NorthernWidget/DataCollector-Foley-Mechatronics/Software/README.md

How to use ArduinoJson

https://github.com/bblanchon/ArduinoJson
