NorthernWidget/DataCollector-Foley-Mechatronics/Final_Presentation/graphics/layering.docx

S6

S5

S4

S3

S2

S1

Main Controller

XBee

Wixel

GSM Module

Gateway API

Data Logger API

Data Service

Wireless Sensor API

Sensor Service
