NorthernWidget/DataCollector-Foley-Mechatronics/Final_Presentation/graphics/GeoLog.pdf

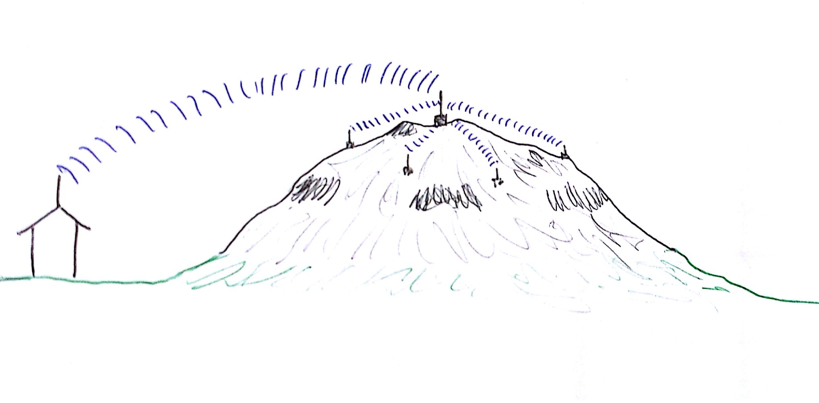
[picture p33: figure]

Scanned by CamScanner
