NorthernWidget/DataCollector-Foley-Mechatronics/Field pictures/IMG_4600.JPG

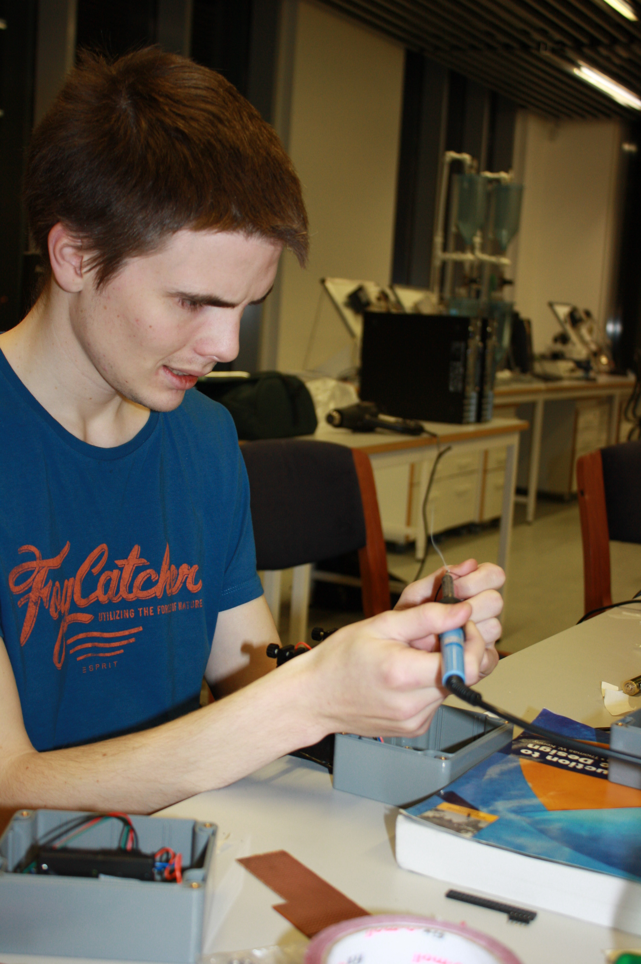
Field pictures/IMG_4600.JPG
