NorthernWidget/DataCollector-Foley-Mechatronics/Field pictures/IMG_4601.JPG

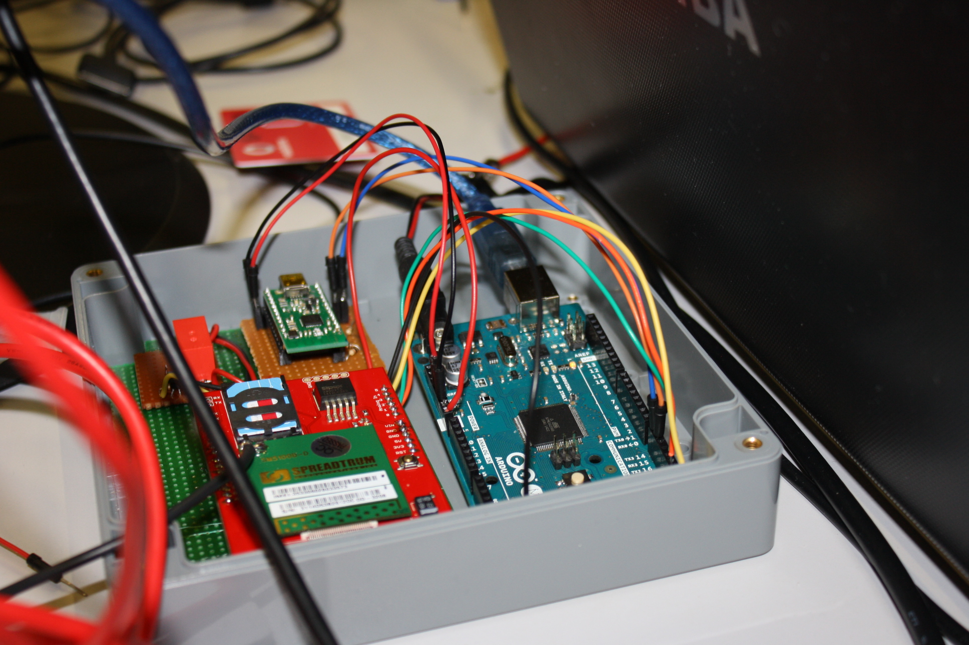
Field pictures/IMG_4601.JPG
