NorthernWidget/DataCollector-Foley-Mechatronics/Field pictures/IMG_4602.JPG

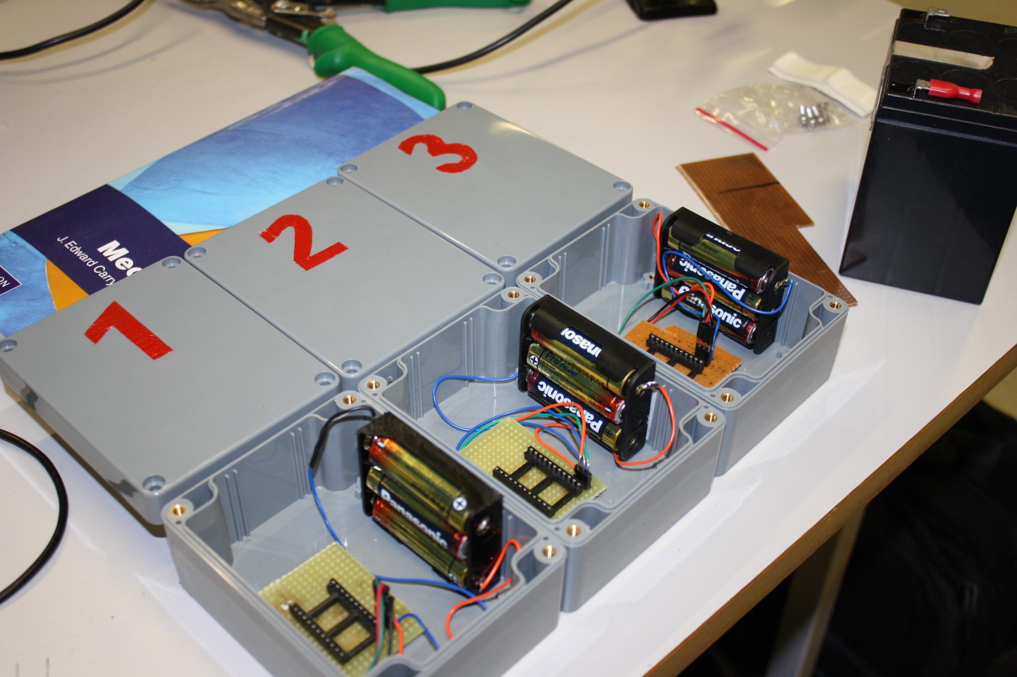
Field pictures/IMG_4602.JPG
