NorthernWidget/DataCollector-Foley-Mechatronics/Field pictures/IMG_4603.JPG

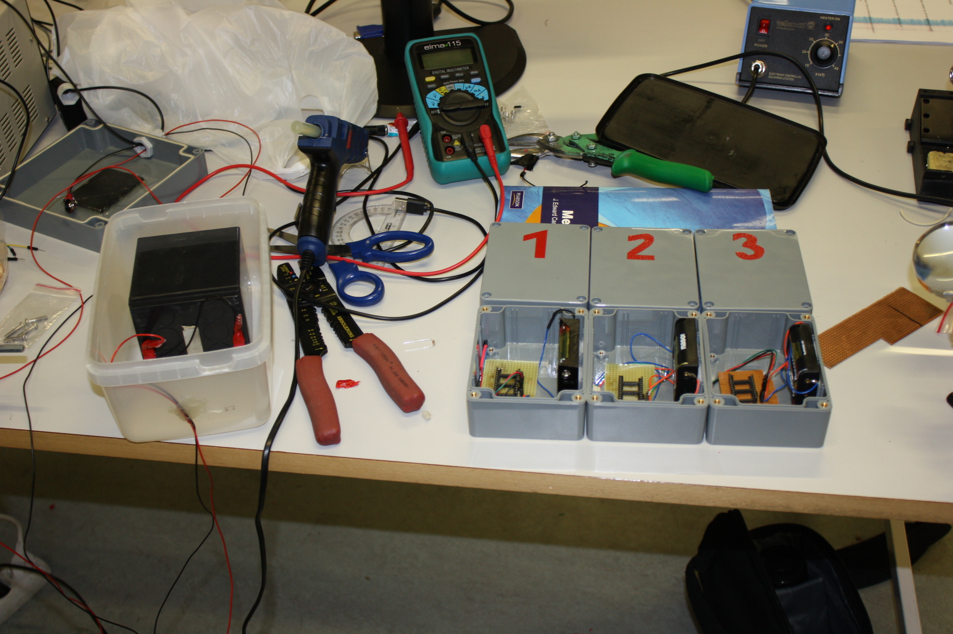
Field pictures/IMG_4603.JPG
