NorthernWidget/DataCollector-Foley-Mechatronics/Field pictures/IMG_4604.JPG

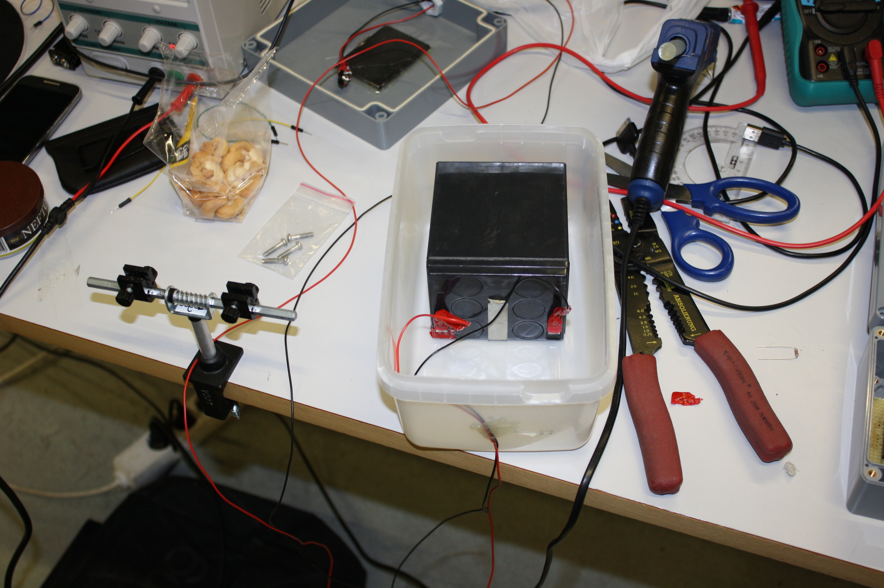
Field pictures/IMG_4604.JPG
