NorthernWidget/DataCollector-Foley-Mechatronics/Field pictures/IMG_4605.JPG

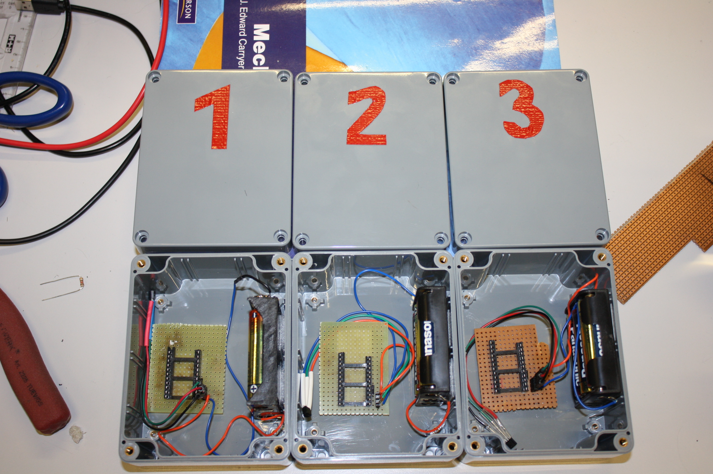
Field pictures/IMG_4605.JPG
