NorthernWidget/DataCollector-Foley-Mechatronics/Field pictures/IMG_4606.JPG

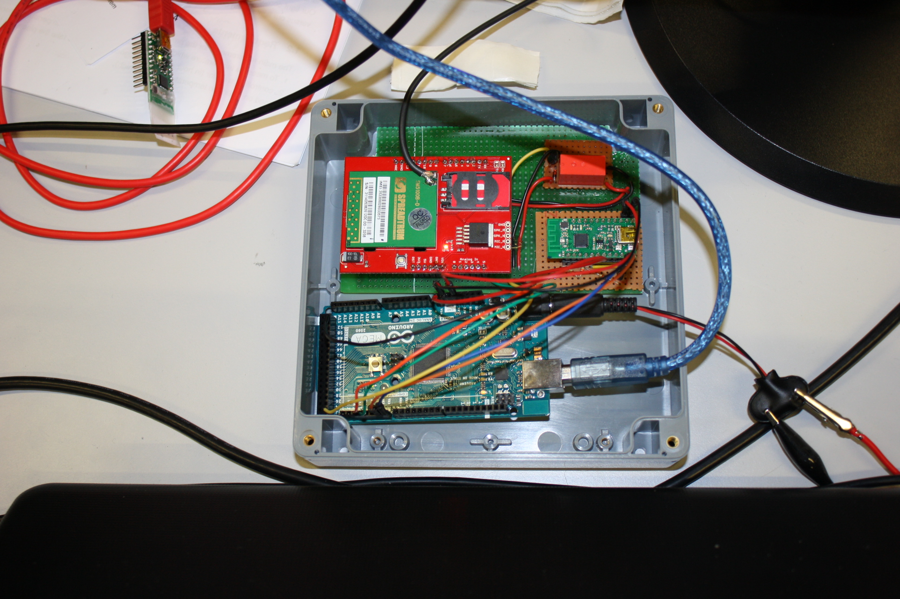
Field pictures/IMG_4606.JPG
