NorthernWidget/DataCollector-Foley-Mechatronics/Field pictures/IMG_4607.JPG

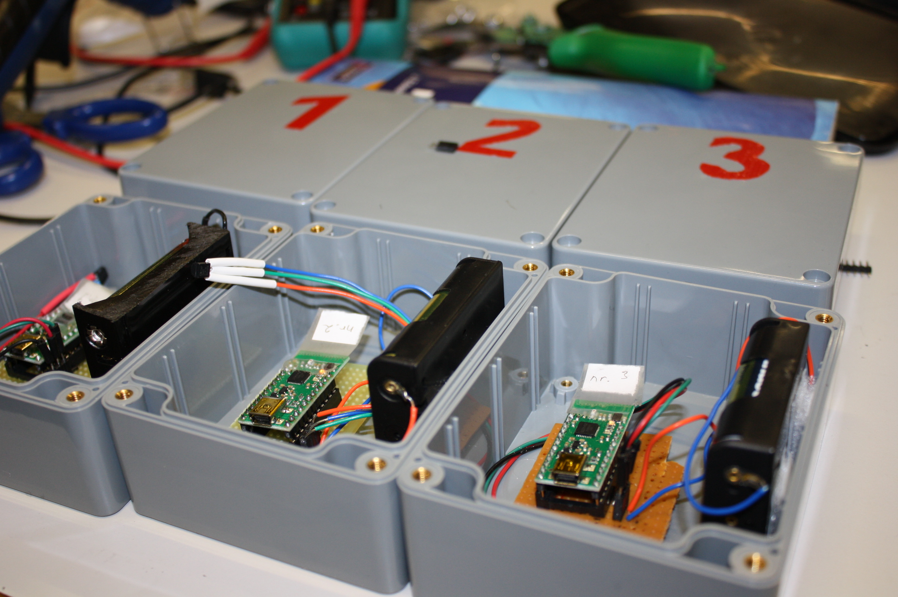
Field pictures/IMG_4607.JPG
