NorthernWidget/DataCollector-Foley-Mechatronics/Field pictures/IMG_4608.JPG

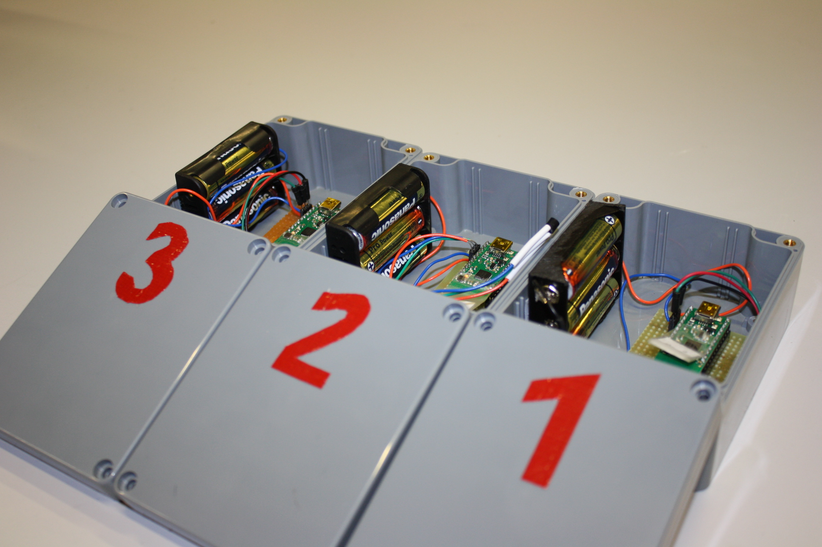
Field pictures/IMG_4608.JPG
