NorthernWidget/DataCollector-Foley-Mechatronics/Field pictures/IMG_4609.JPG

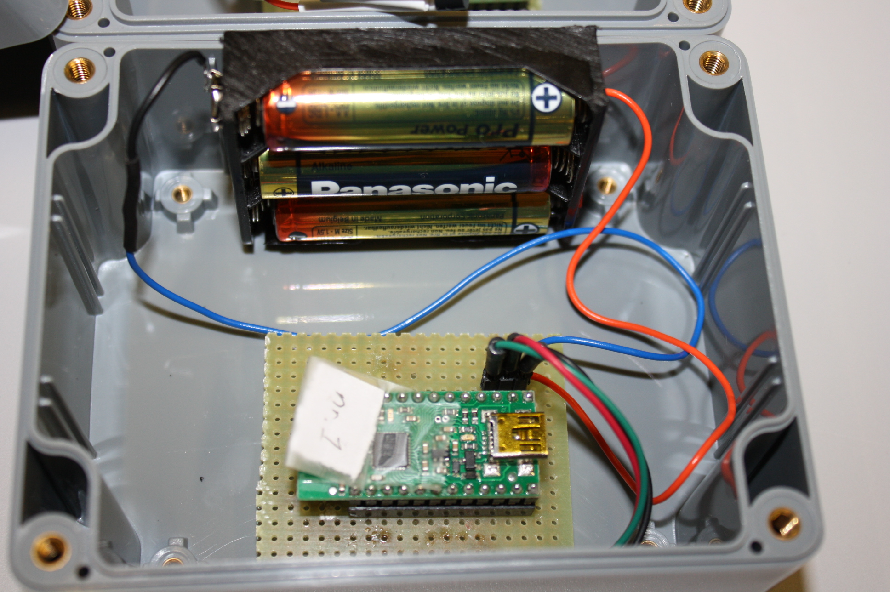
Field pictures/IMG_4609.JPG
