NorthernWidget/DataCollector-Foley-Mechatronics/Field pictures/IMG_4610.JPG

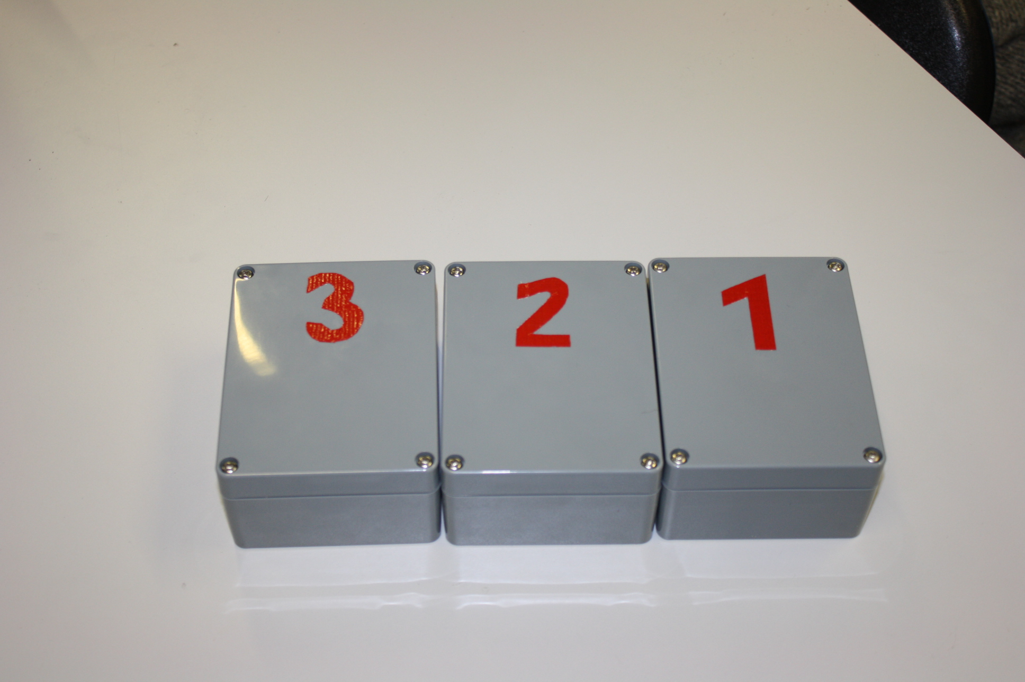
Field pictures/IMG_4610.JPG
