NorthernWidget/DataCollector-Foley-Mechatronics/Field pictures/IMG_4611.JPG

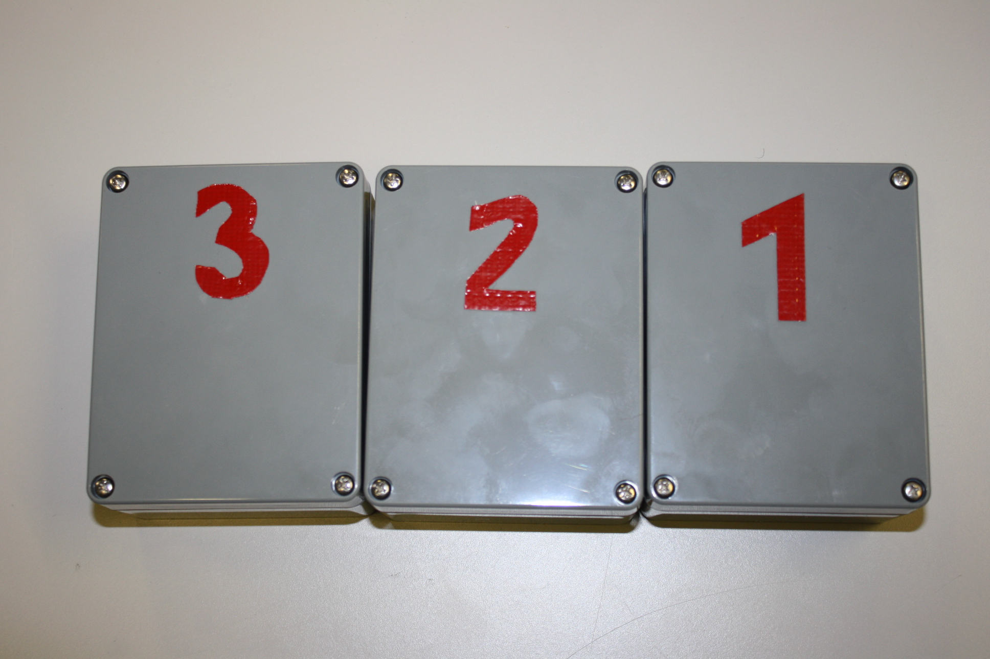
Field pictures/IMG_4611.JPG
