NorthernWidget/DataCollector-Foley-Mechatronics/Field pictures/IMG_4612.JPG

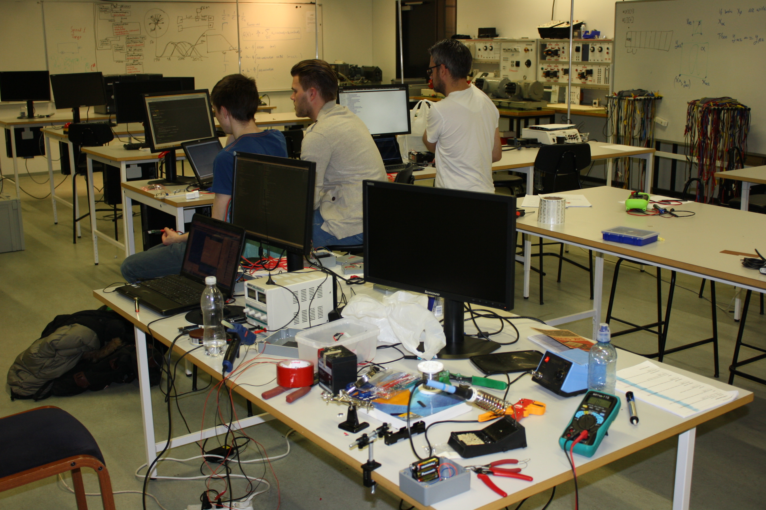
Field pictures/IMG_4612.JPG
