NorthernWidget/DataCollector-Foley-Mechatronics/Field pictures/IMG_4613.JPG

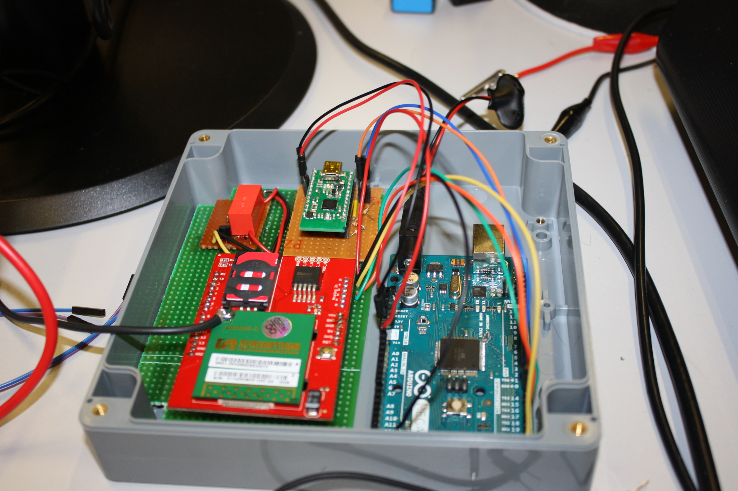
Field pictures/IMG_4613.JPG
