NorthernWidget/DataCollector-Foley-Mechatronics/Field pictures/IMG_4615.JPG

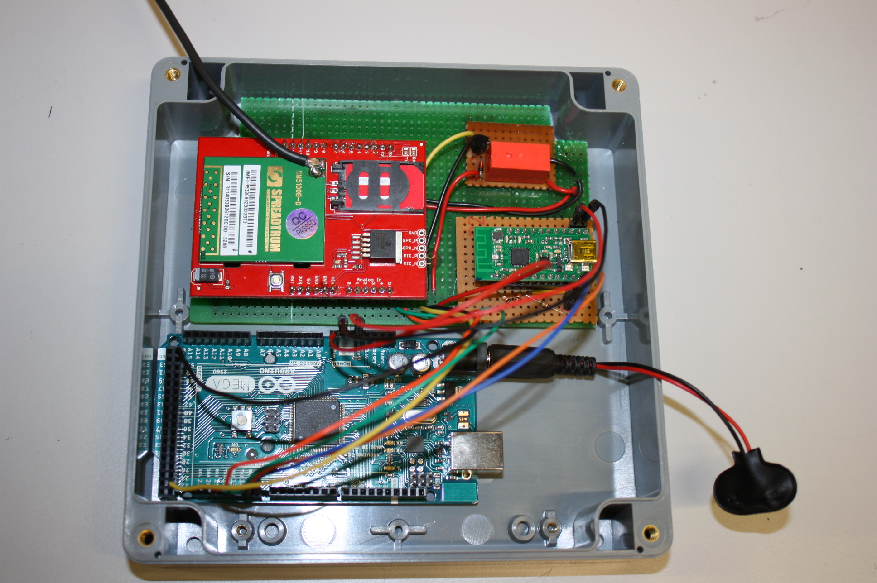
Field pictures/IMG_4615.JPG
