NorthernWidget/DataCollector-Foley-Mechatronics/Field pictures/IMG_4616.JPG

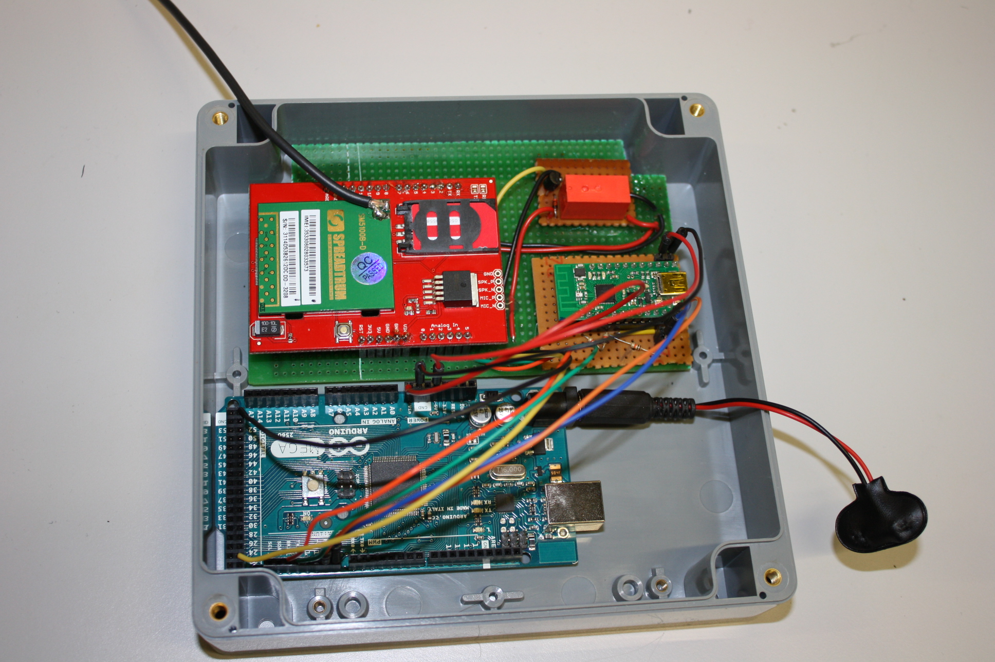
Field pictures/IMG_4616.JPG
