NorthernWidget/DataCollector-Foley-Mechatronics/Field pictures/IMG_4617.JPG

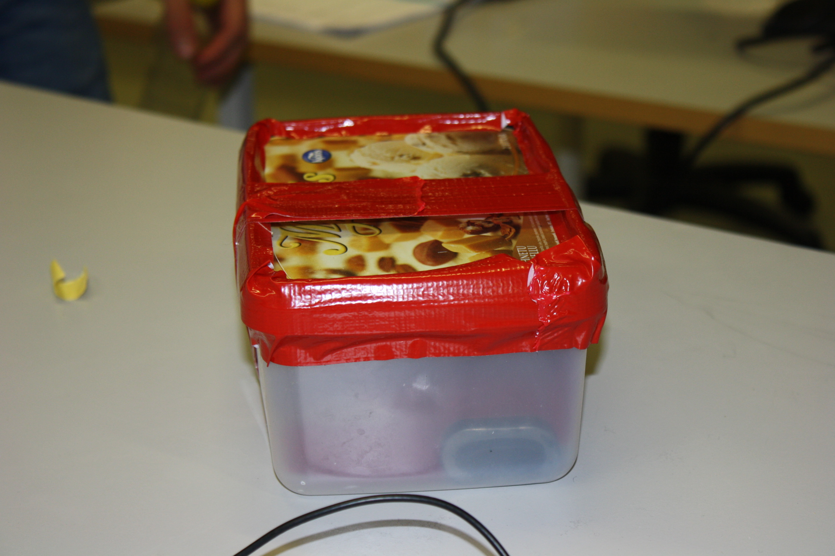
Field pictures/IMG_4617.JPG
