NorthernWidget/DataCollector-Foley-Mechatronics/Field pictures/IMG_4618.JPG

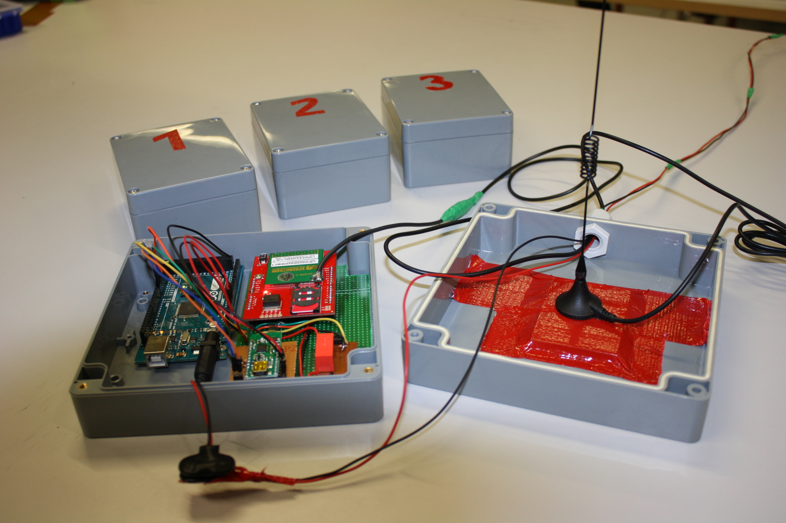
Field pictures/IMG_4618.JPG
