NorthernWidget/DataCollector-Foley-Mechatronics/Field pictures/IMG_4619.JPG

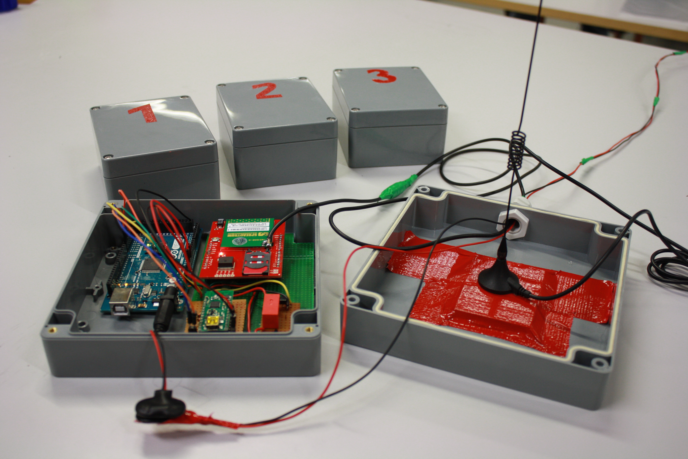
Field pictures/IMG_4619.JPG
