NorthernWidget/DataCollector-Foley-Mechatronics/Field pictures/IMG_4620.JPG

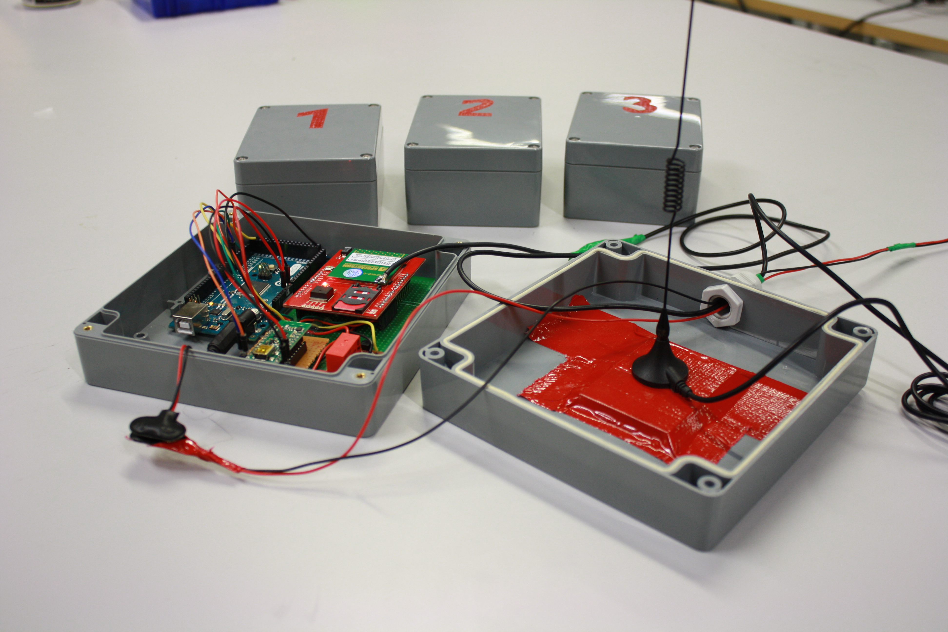
Field pictures/IMG_4620.JPG
