NorthernWidget/DataCollector-Foley-Mechatronics/Field pictures/IMG_4621.JPG

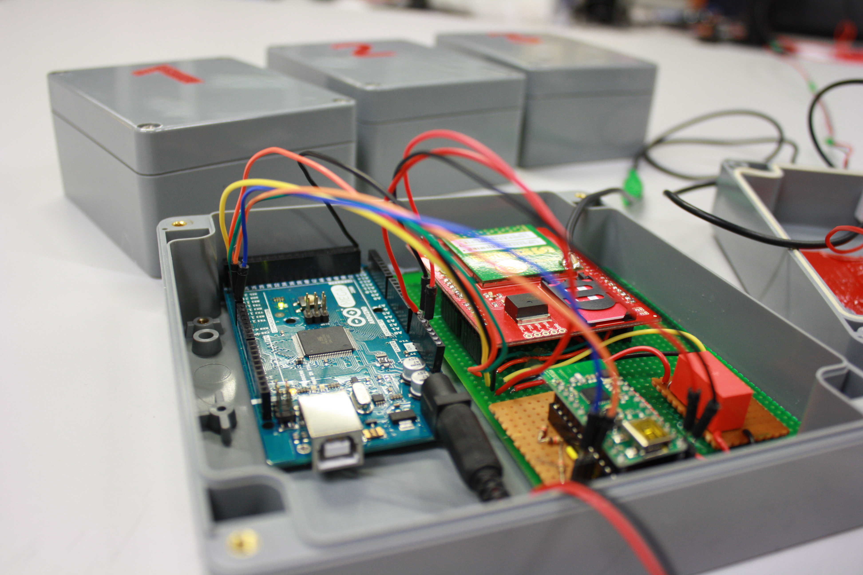
Field pictures/IMG_4621.JPG
