NorthernWidget/DataCollector-Foley-Mechatronics/Field pictures/IMG_4622.JPG

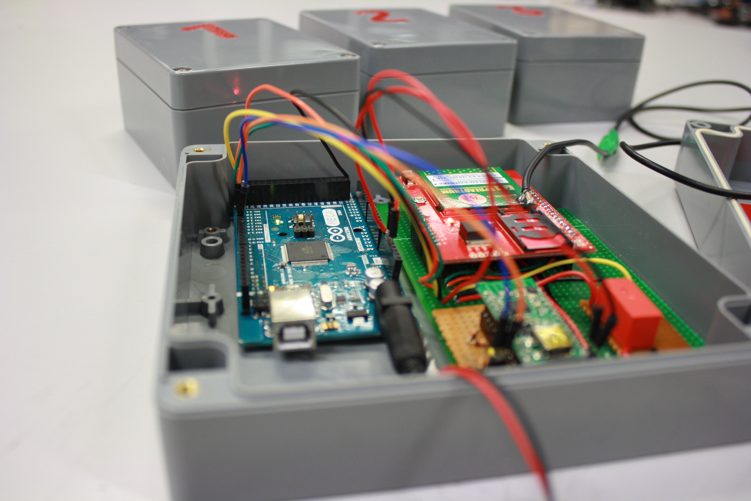
Field pictures/IMG_4622.JPG
