NorthernWidget/DataCollector-Foley-Mechatronics/Field pictures/IMG_4623.JPG

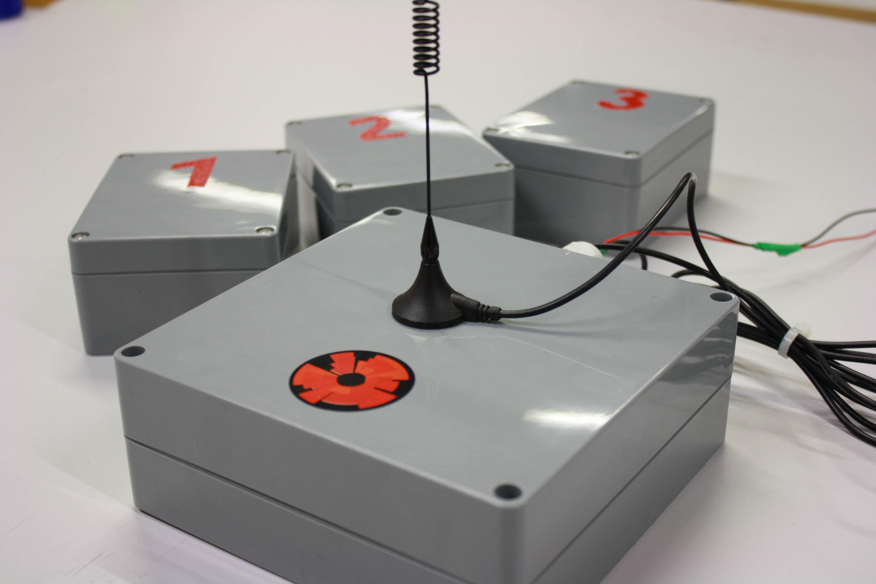
Field pictures/IMG_4623.JPG
