NorthernWidget/DataCollector-Foley-Mechatronics/Field pictures/IMG_4624.JPG

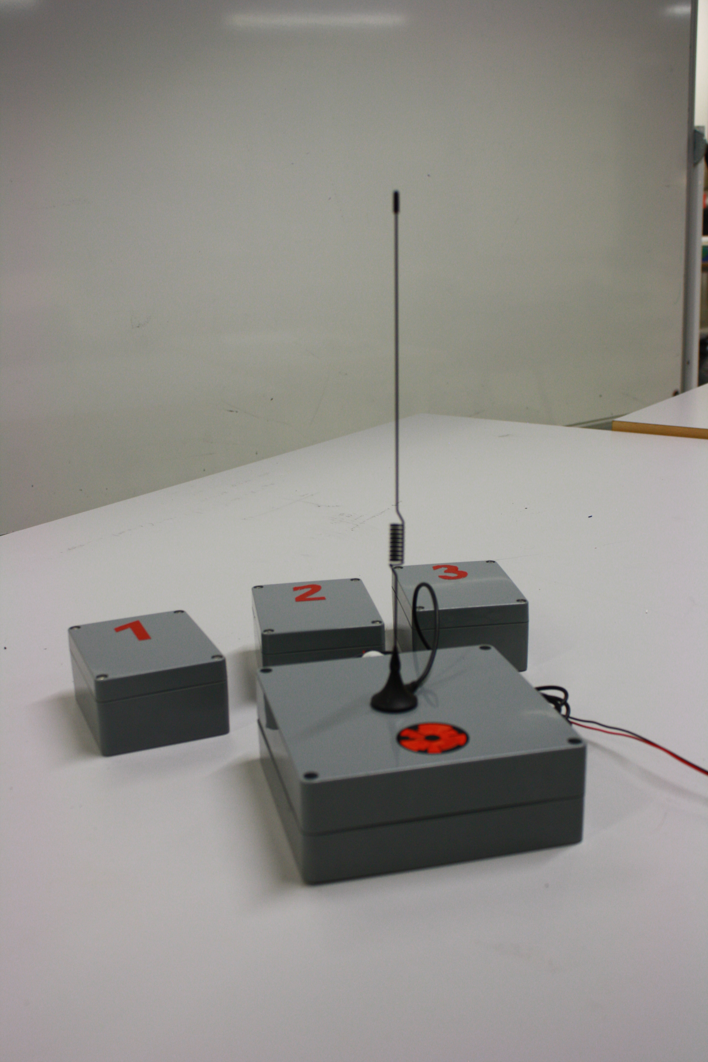
Field pictures/IMG_4624.JPG
