NorthernWidget/DataCollector-Foley-Mechatronics/Field pictures/IMG_4625.JPG

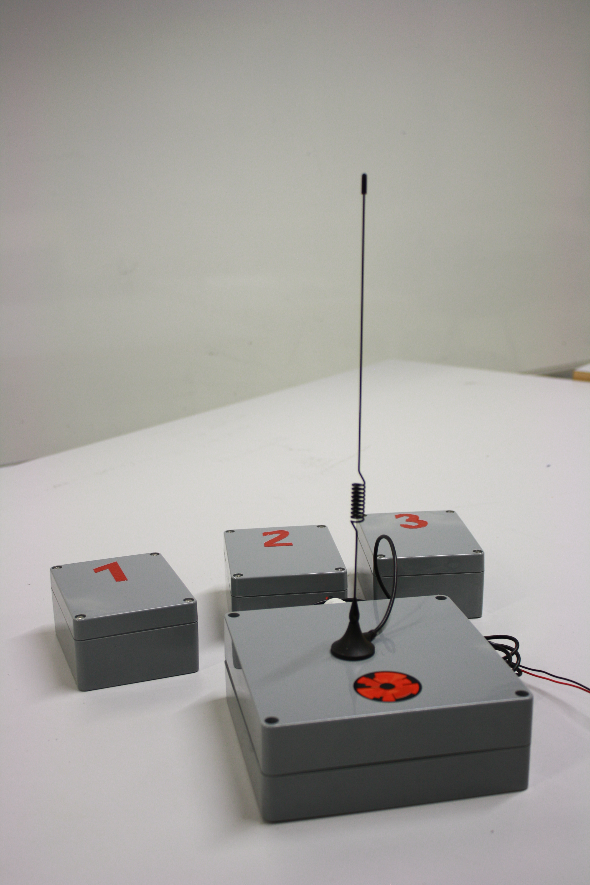
Field pictures/IMG_4625.JPG
