NorthernWidget/DataCollector-Foley-Mechatronics/Field pictures/IMG_4626.JPG

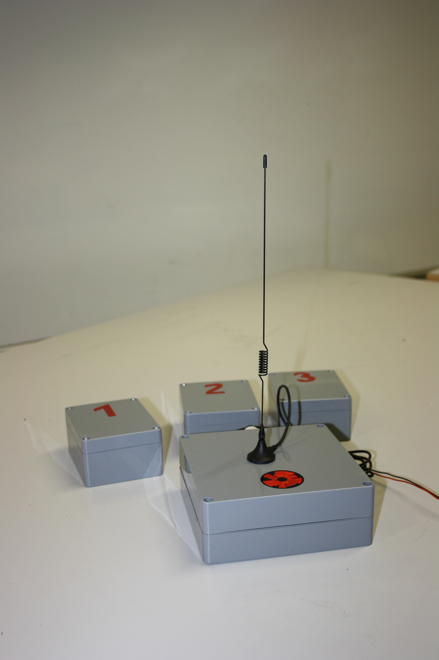
Field pictures/IMG_4626.JPG
