NorthernWidget/DataCollector-Foley-Mechatronics/Field pictures/IMG_4627.JPG

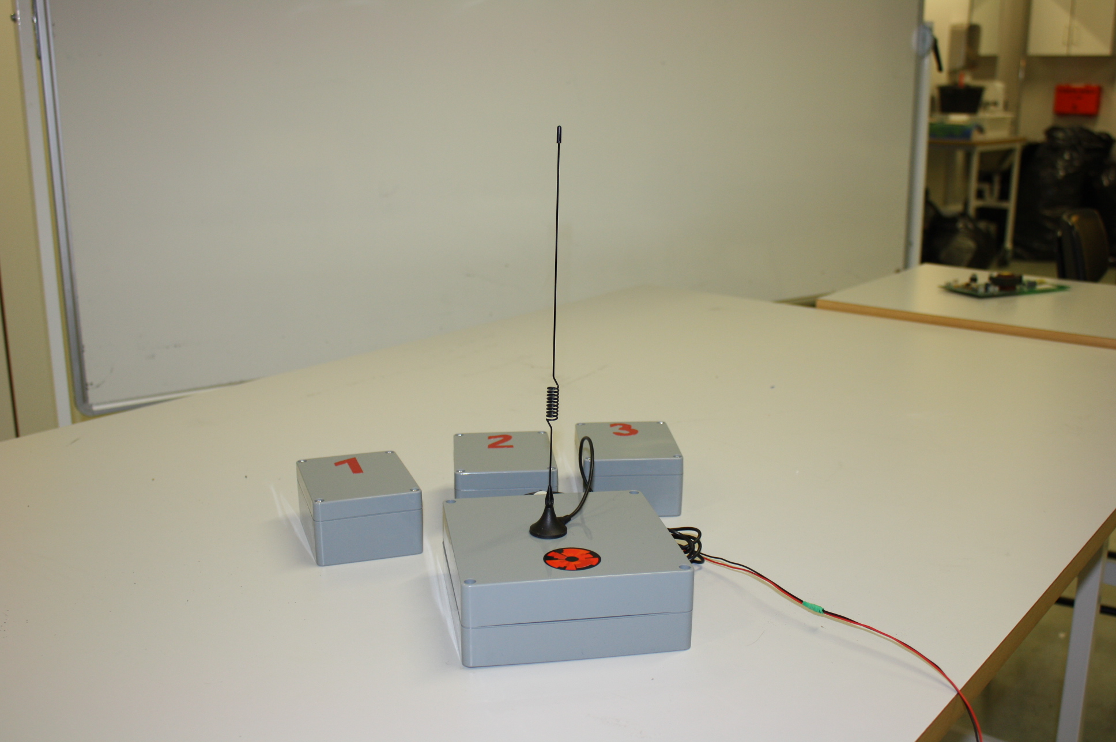
Field pictures/IMG_4627.JPG
