NorthernWidget/DataCollector-Foley-Mechatronics/Field pictures/IMG_4628.JPG

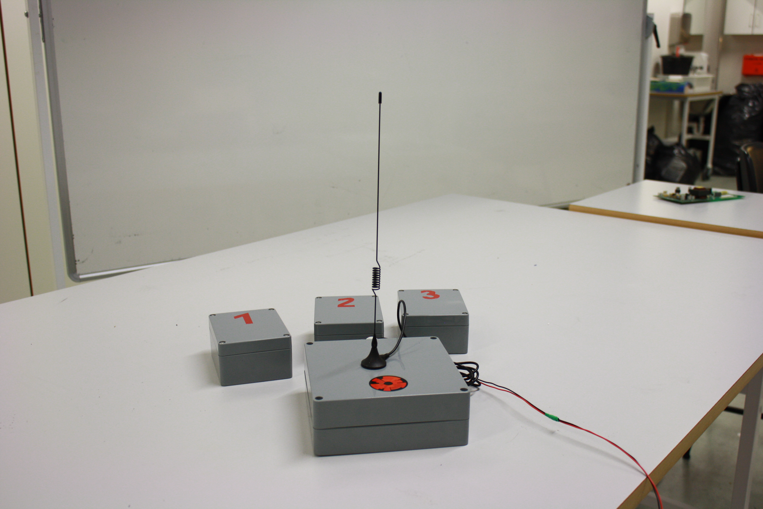
Field pictures/IMG_4628.JPG
