NorthernWidget/DataCollector-Foley-Mechatronics/Field pictures/IMG_4629.JPG

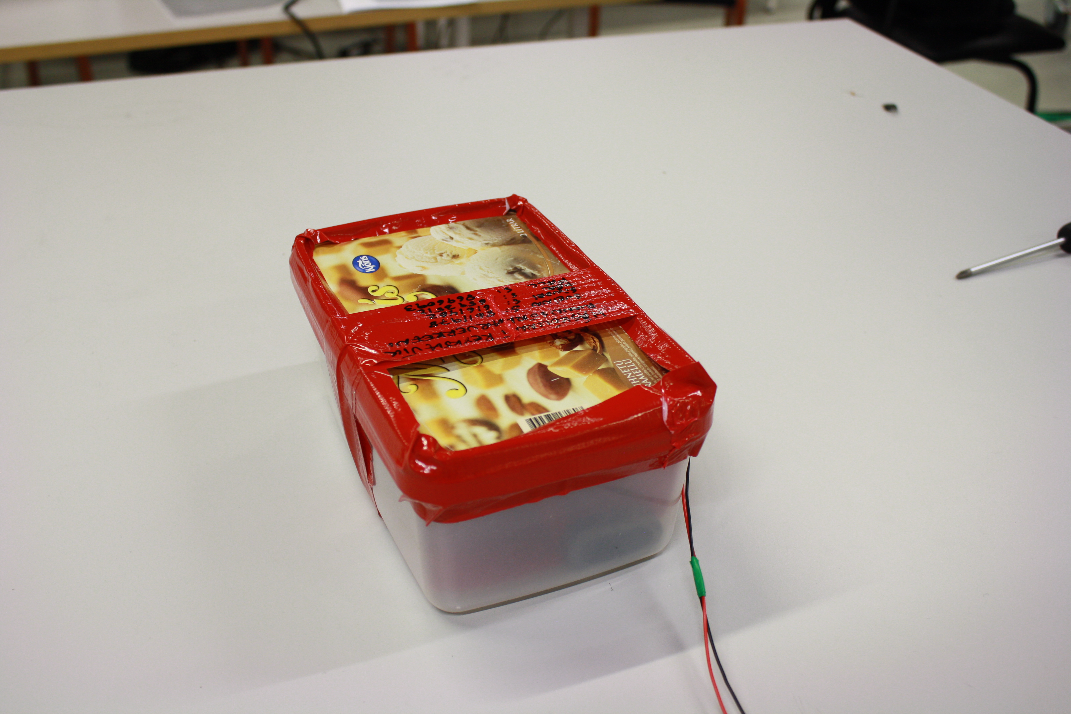
Field pictures/IMG_4629.JPG
