NorthernWidget/DataCollector-Foley-Mechatronics/Field pictures/IMG_4630.JPG

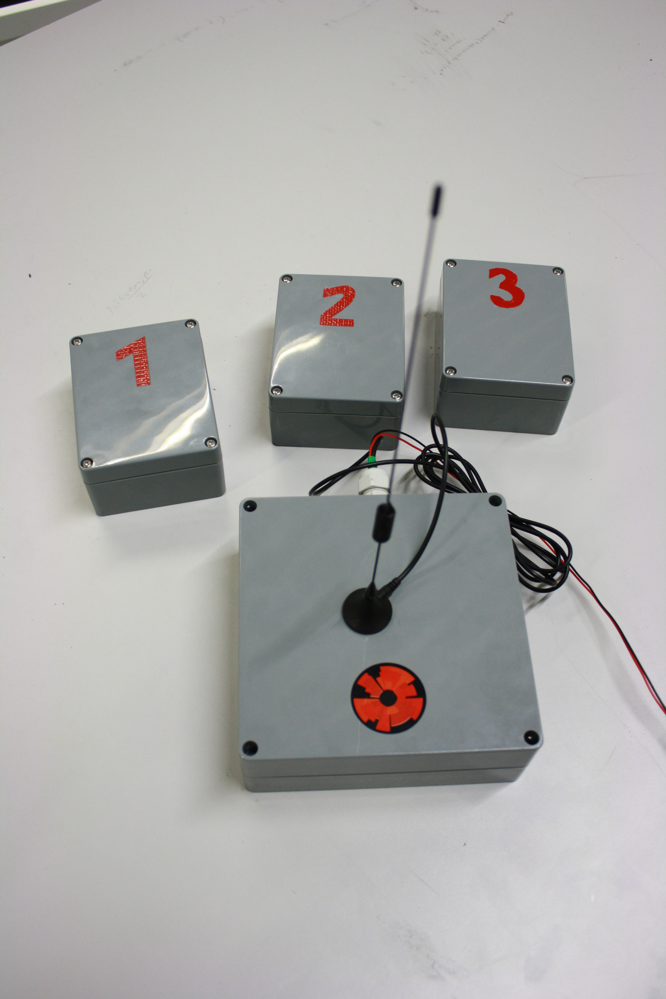
Field pictures/IMG_4630.JPG
