NorthernWidget/DataCollector-Foley-Mechatronics/Field pictures/IMG_4631.JPG

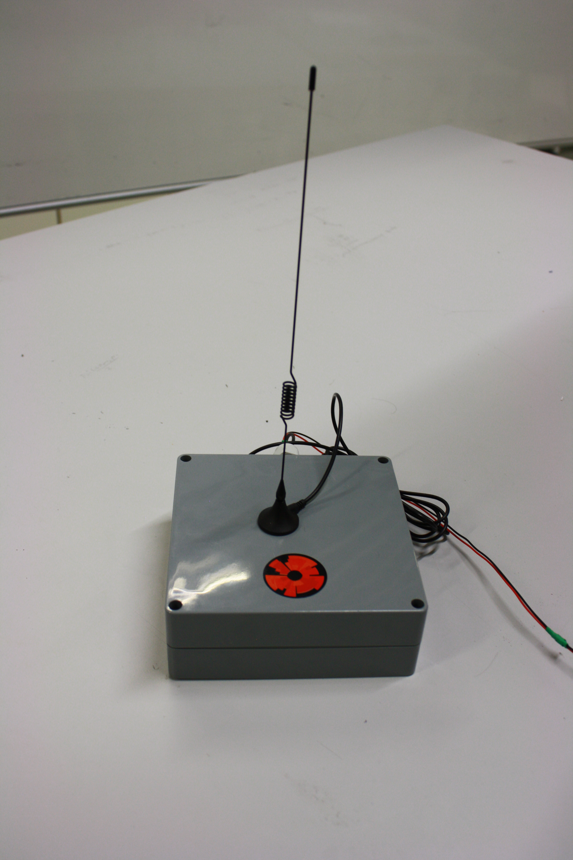
Field pictures/IMG_4631.JPG
