NorthernWidget/DataCollector-Foley-Mechatronics/Field pictures/IMG_4632.JPG

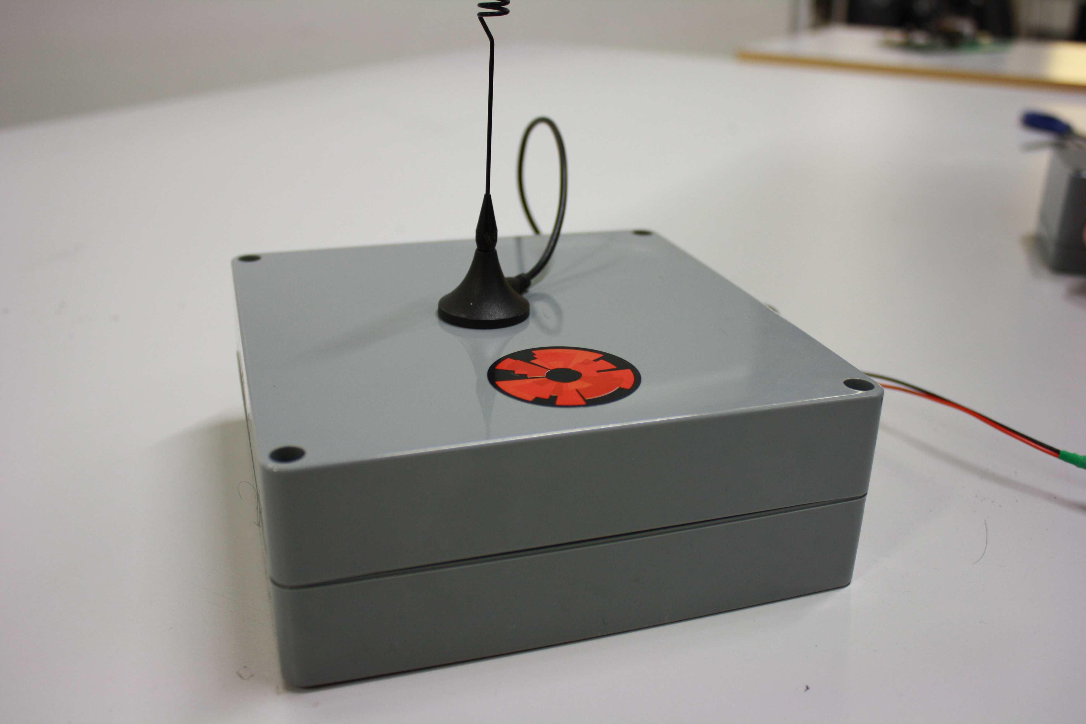
Field pictures/IMG_4632.JPG
