NorthernWidget/DataCollector-Foley-Mechatronics/Field pictures/IMG_4633.JPG

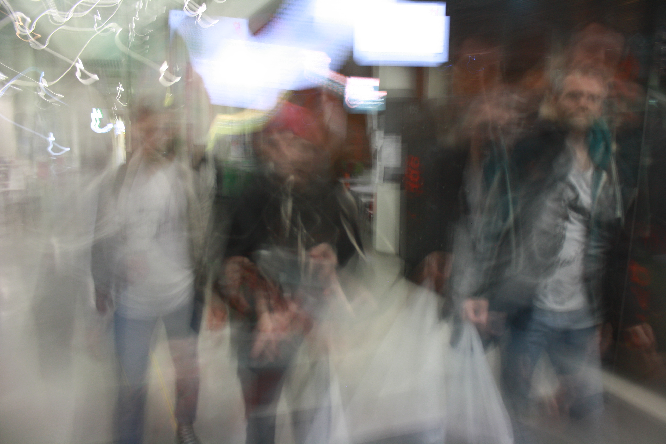
Field pictures/IMG_4633.JPG
