NorthernWidget/DataCollector-Foley-Mechatronics/Field pictures/IMG_4634.JPG

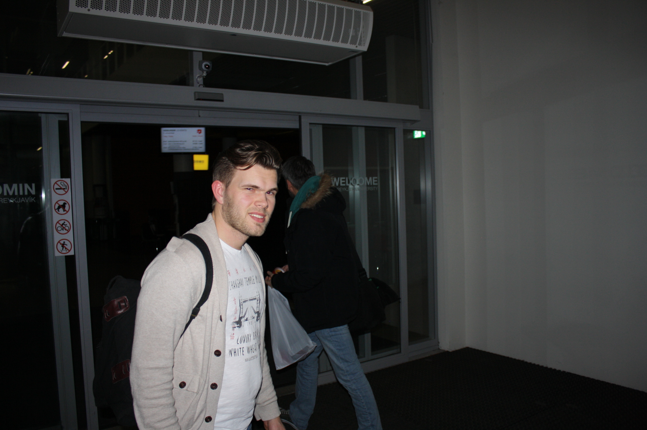
Field pictures/IMG_4634.JPG
