NorthernWidget/DataCollector-Foley-Mechatronics/Field pictures/IMG_4635.JPG

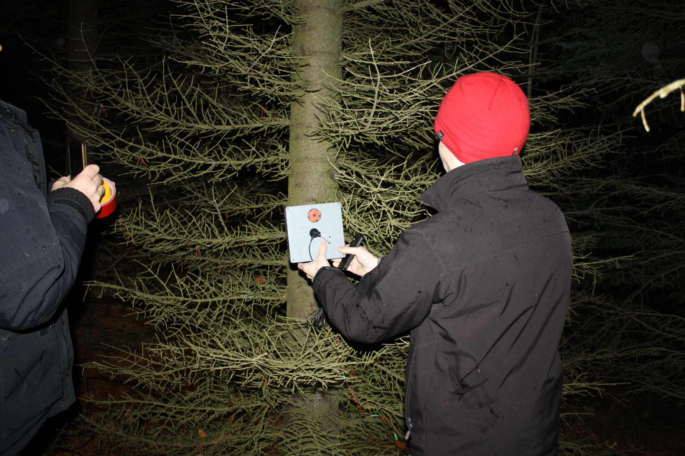
Field pictures/IMG_4635.JPG
