NorthernWidget/DataCollector-Foley-Mechatronics/Field pictures/IMG_4636.JPG

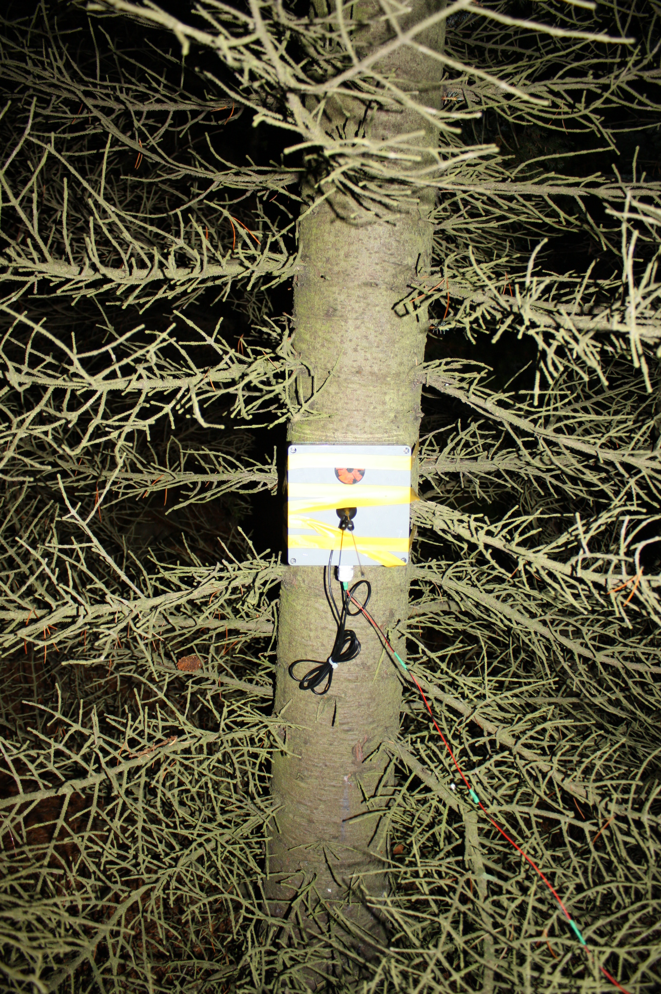
Field pictures/IMG_4636.JPG
