NorthernWidget/DataCollector-Foley-Mechatronics/Field pictures/IMG_4637.JPG

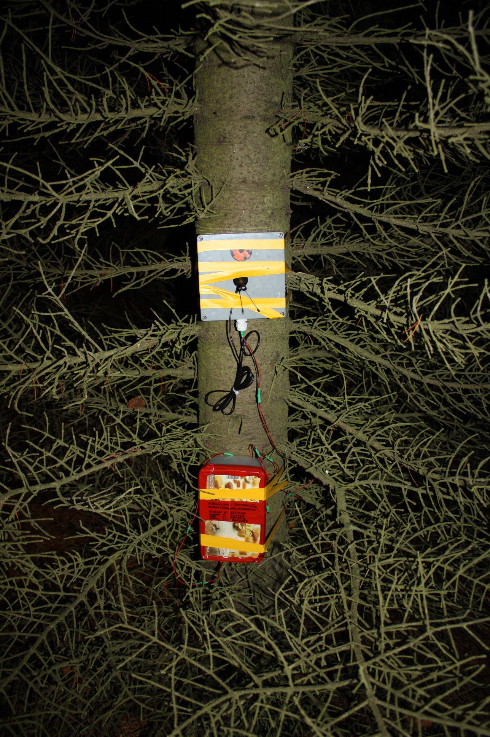
Field pictures/IMG_4637.JPG
