NorthernWidget/DataCollector-Foley-Mechatronics/Field pictures/IMG_4638.JPG

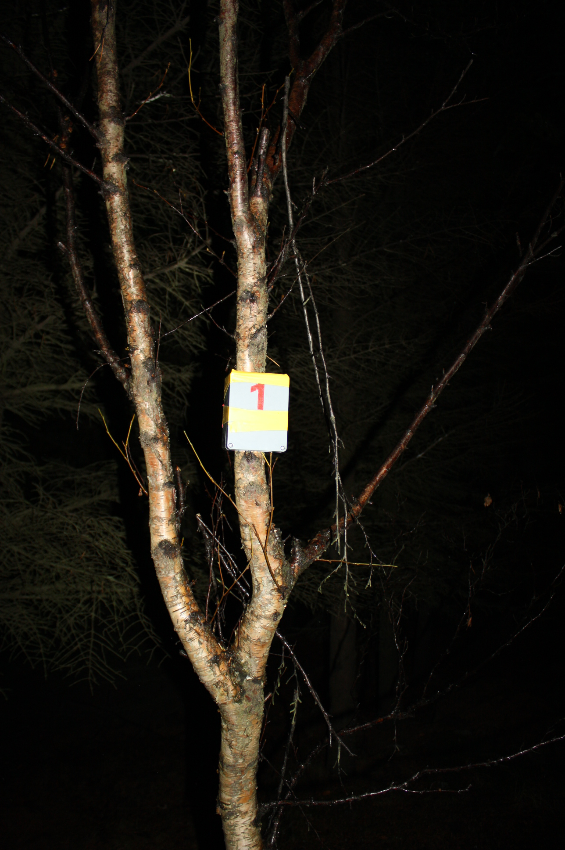
Field pictures/IMG_4638.JPG
