NorthernWidget/DataCollector-Foley-Mechatronics/Field pictures/IMG_4639.JPG

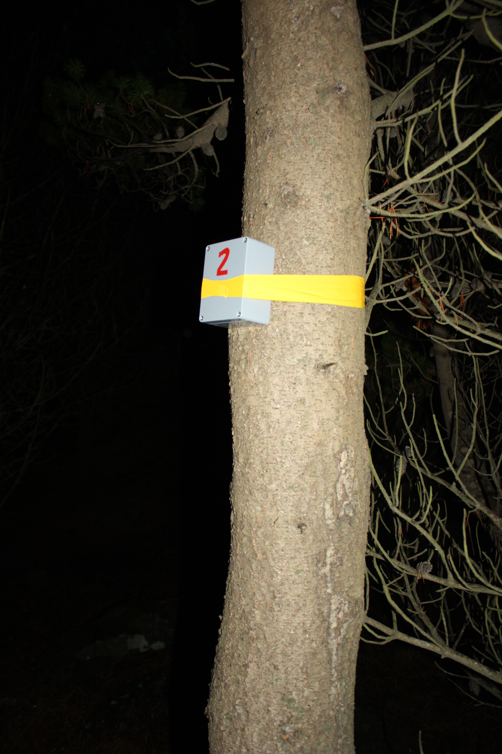
Field pictures/IMG_4639.JPG
