NorthernWidget/DataCollector-Foley-Mechatronics/Field pictures/IMG_4640.JPG

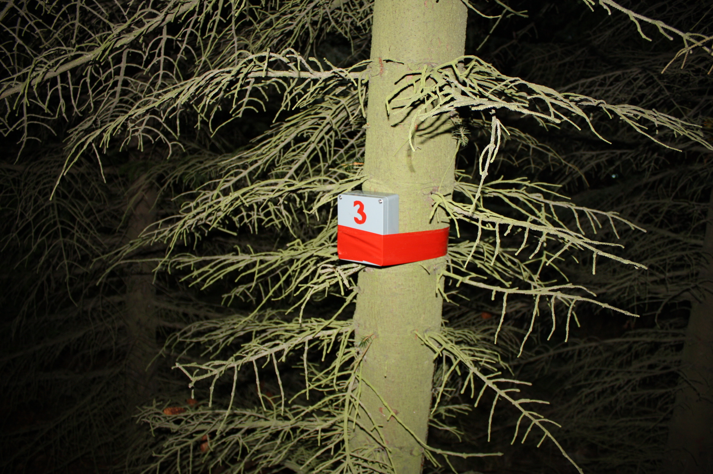
Field pictures/IMG_4640.JPG
