NorthernWidget/DataCollector-Foley-Mechatronics/Field pictures/IMG_4642.JPG

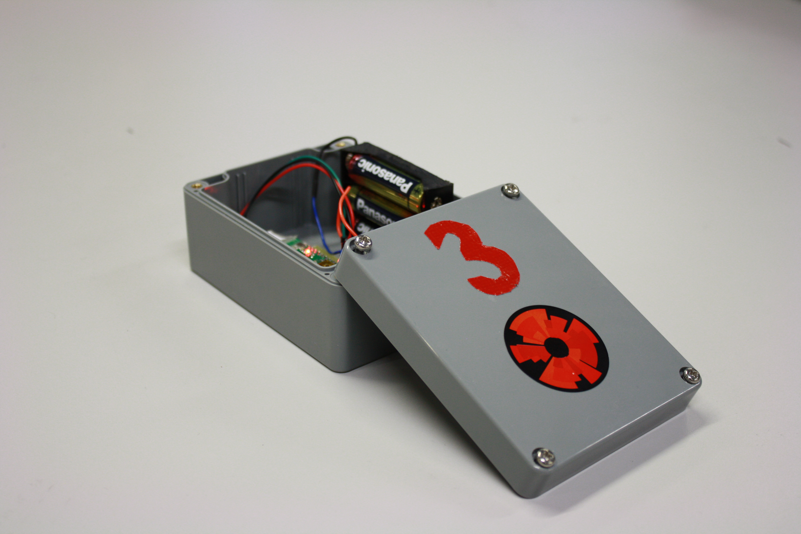
Field pictures/IMG_4642.JPG
