NorthernWidget/DataCollector-Foley-Mechatronics/Field pictures/IMG_4643.JPG

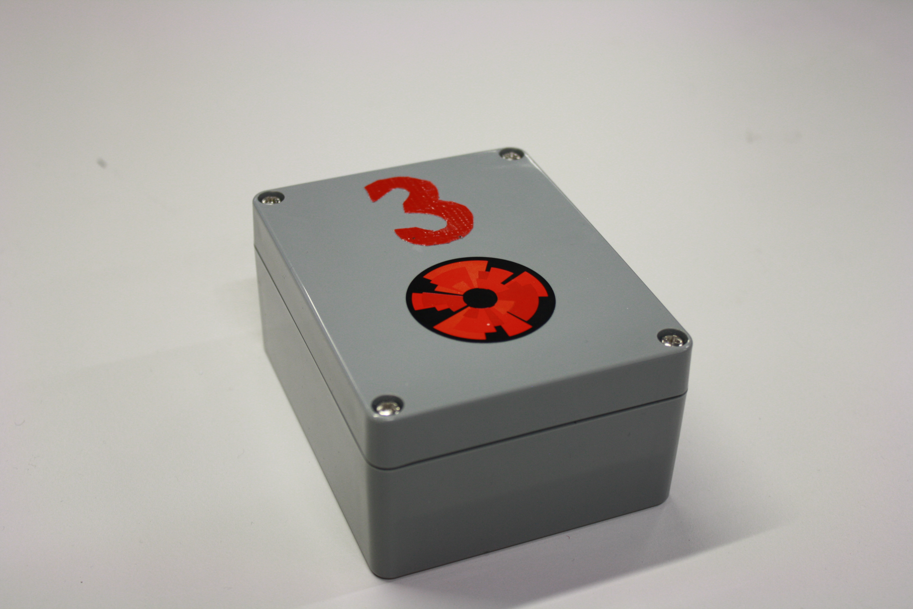
Field pictures/IMG_4643.JPG
