NorthernWidget/DataCollector-Foley-Mechatronics/Field pictures/IMG_4644.JPG

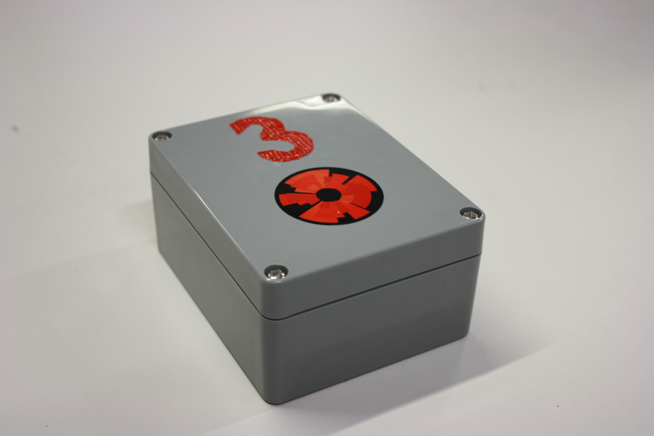
Field pictures/IMG_4644.JPG
