NorthernWidget/DataCollector-Foley-Mechatronics/Field pictures/IMG_4647.JPG

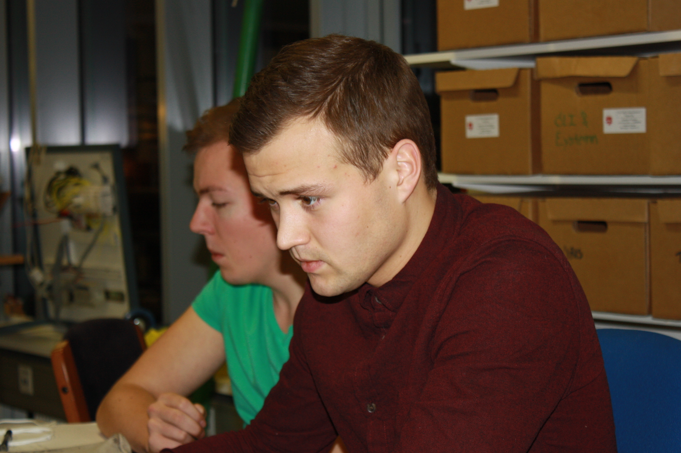
Field pictures/IMG_4647.JPG
