NorthernWidget/DataCollector-Foley-Mechatronics/Field pictures/IMG_4648.JPG

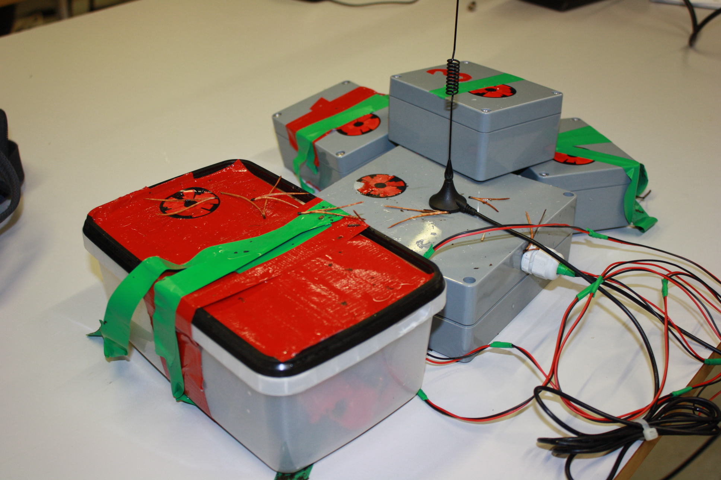
Field pictures/IMG_4648.JPG
