NorthernWidget/DataCollector-Foley-Mechatronics/Field pictures/IMG_4649.JPG

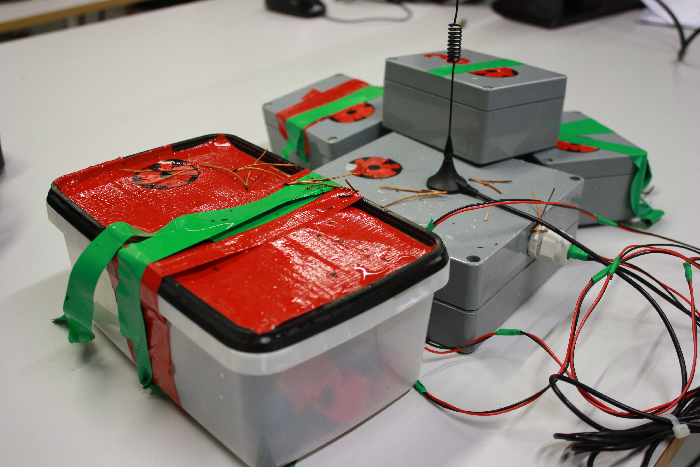
Field pictures/IMG_4649.JPG
