NorthernWidget/DataCollector-Foley-Mechatronics/Field pictures/IMG_4650.JPG

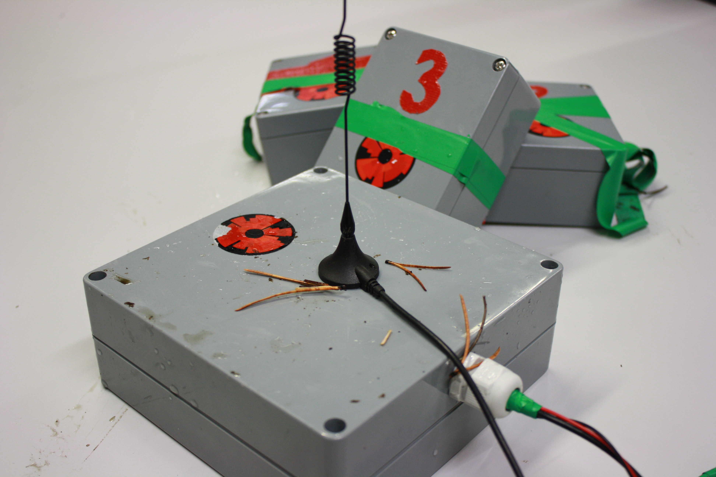
Field pictures/IMG_4650.JPG
