NorthernWidget/DataCollector-Foley-Mechatronics/Field pictures/IMG_4651.JPG

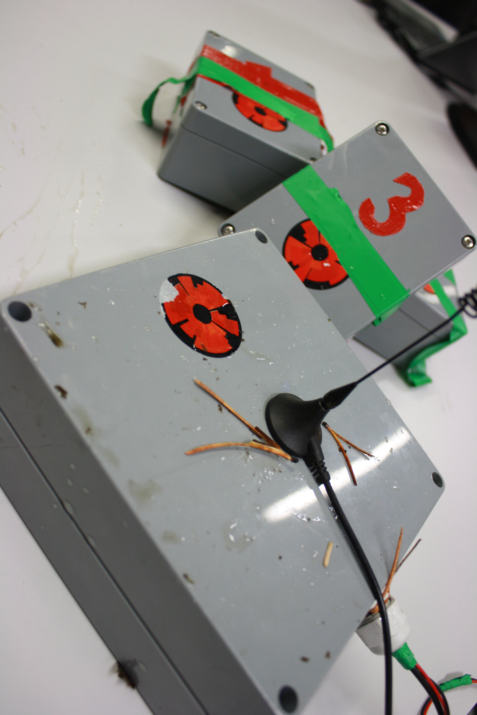
Field pictures/IMG_4651.JPG
