NorthernWidget/DataCollector-Foley-Mechatronics/Field pictures/IMG_4652.JPG

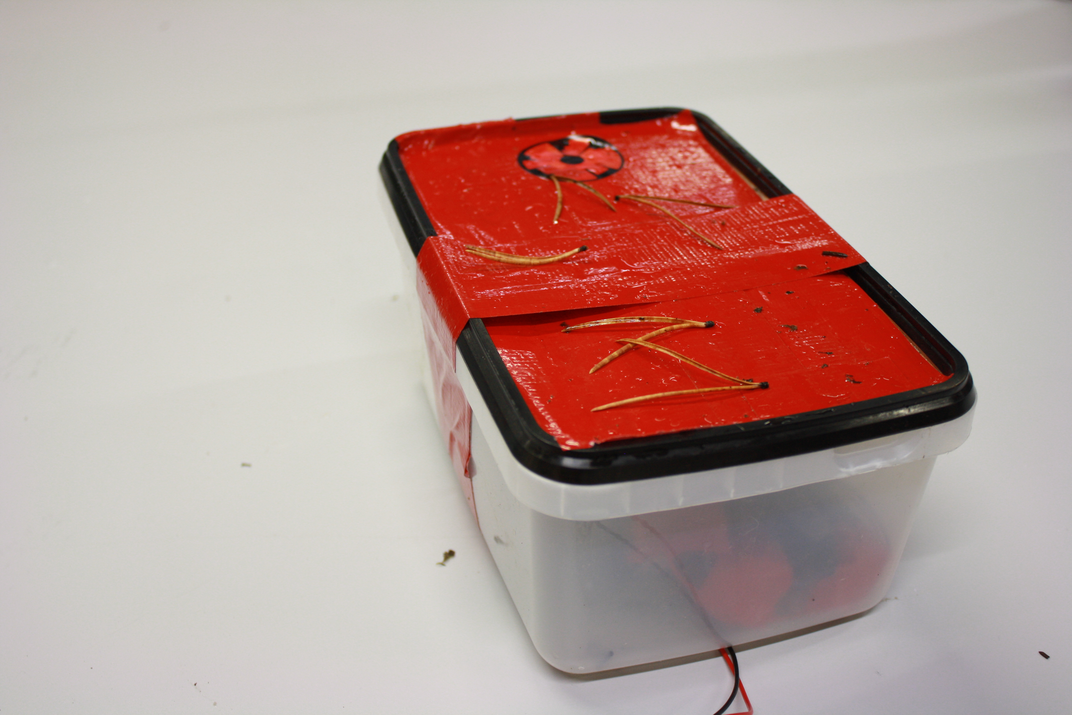
Field pictures/IMG_4652.JPG
