NorthernWidget/DataCollector-Foley-Mechatronics/Field pictures/IMG_4653.JPG

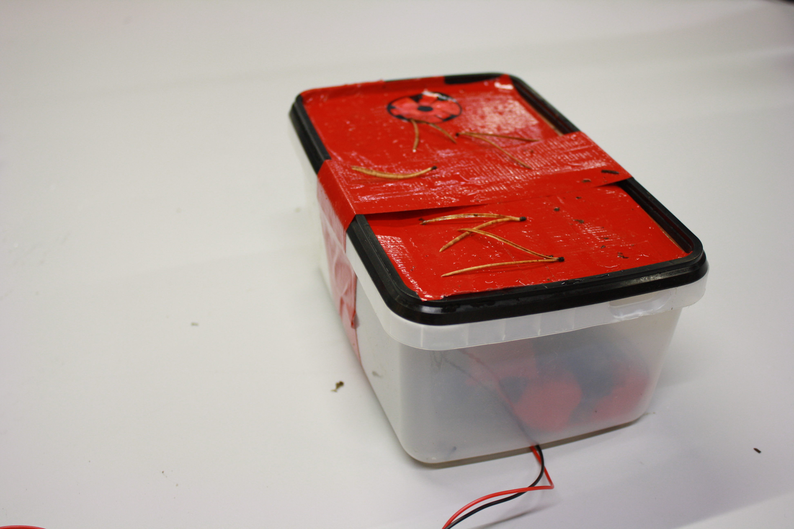
Field pictures/IMG_4653.JPG
