NorthernWidget/DataCollector-Foley-Mechatronics/Field pictures/Photo 5.11.2014, 03 38 04.jpg

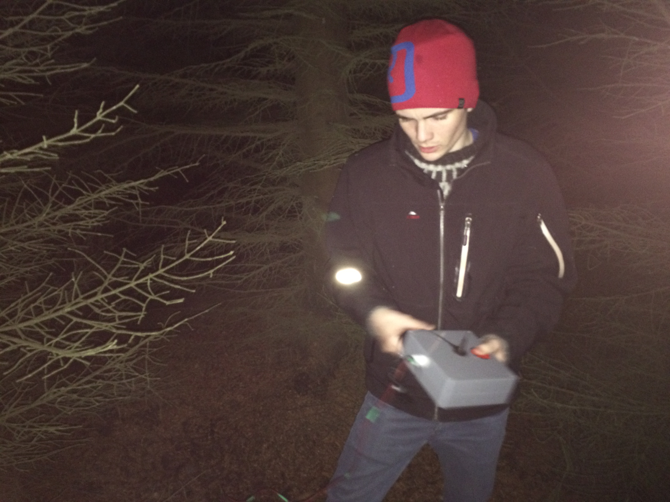
Field pictures/Photo 5.11.2014, 03 38 04.jpg
