NorthernWidget/DataCollector-Foley-Mechatronics/Field pictures/Photo 5.11.2014, 17 06 54.jpg

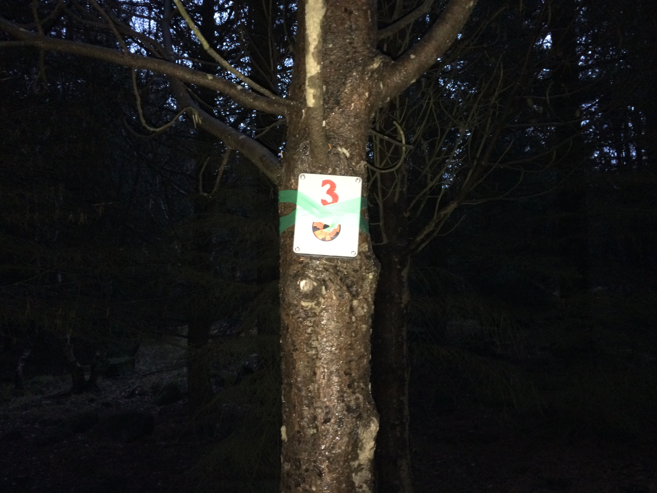
Field pictures/Photo 5.11.2014, 17 06 54.jpg
