NorthernWidget/DataCollector-Foley-Mechatronics/Field pictures/Photo 5.11.2014, 17 09 20.jpg

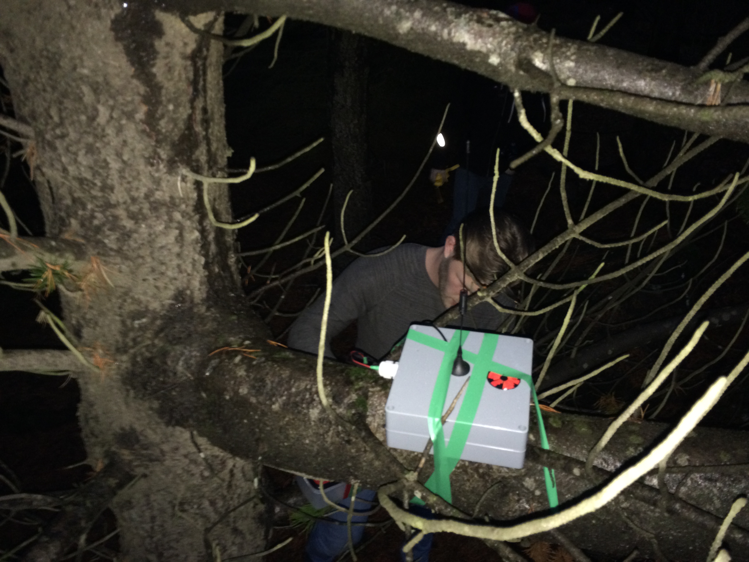
Field pictures/Photo 5.11.2014, 17 09 20.jpg
