NorthernWidget/DataCollector-Foley-Mechatronics/Final_Presentation/graphics/affordableWS.png

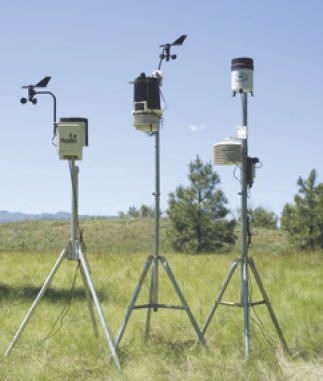
Final_Presentation/graphics/affordableWS.png
