NorthernWidget/DataCollector-Foley-Mechatronics/Final_Presentation/graphics/Field_pictures/Power.JPG

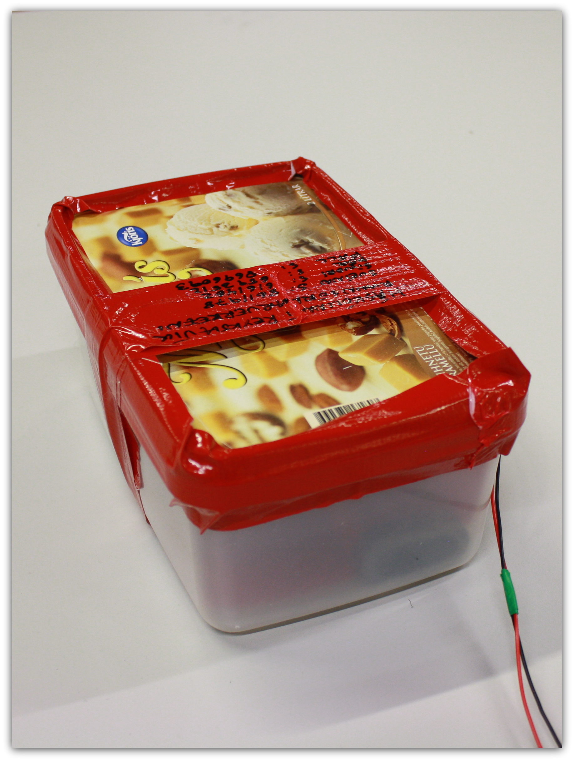
Final_Presentation/graphics/Field_pictures/Power.JPG
