NorthernWidget/DataCollector-Foley-Mechatronics/Final_Presentation/graphics/softwareArchitecture.png

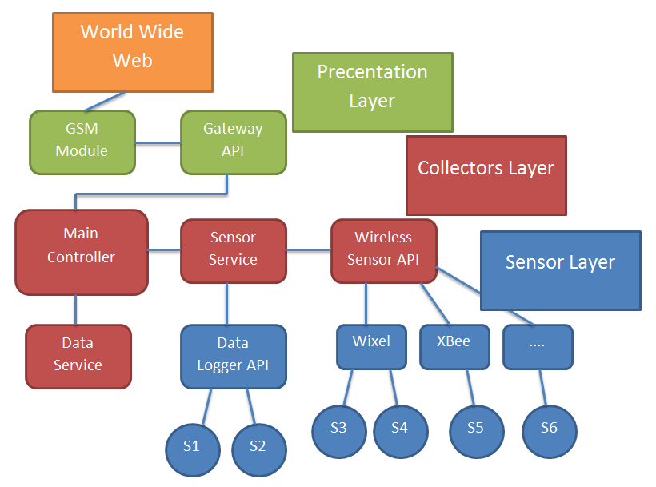
Final_Presentation/graphics/softwareArchitecture.png
