NorthernWidget/DataCollector-Foley-Mechatronics/Proposal/graphics/milestonePresentation.jpg

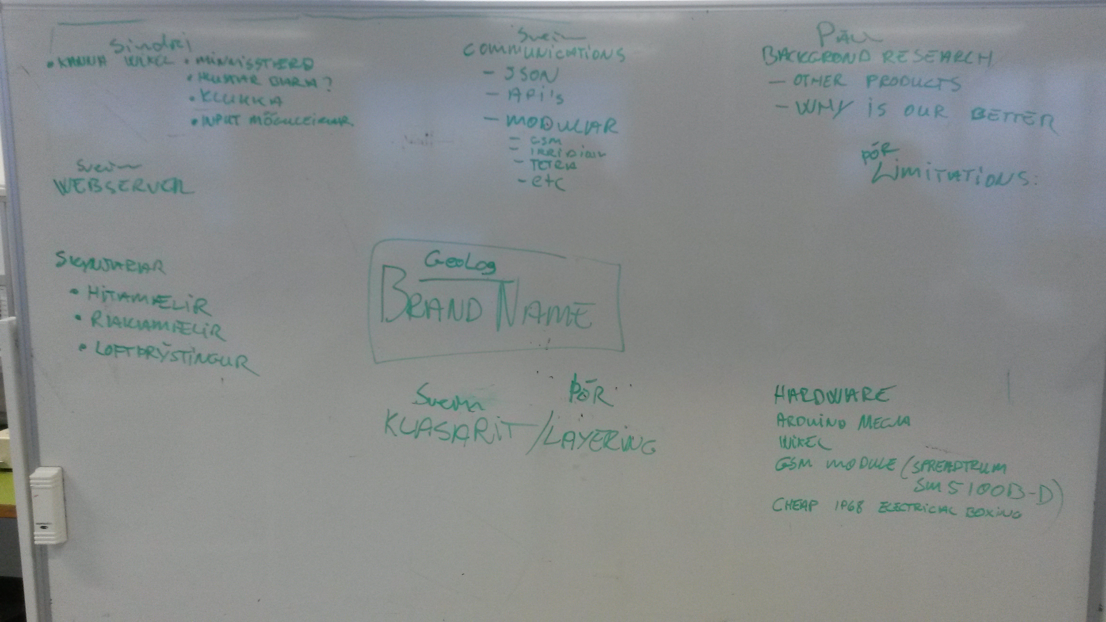
Proposal/graphics/milestonePresentation.jpg
