NorthernWidget/DataCollector-Foley-Mechatronics/Proposal/graphics/powerSaving.jpg

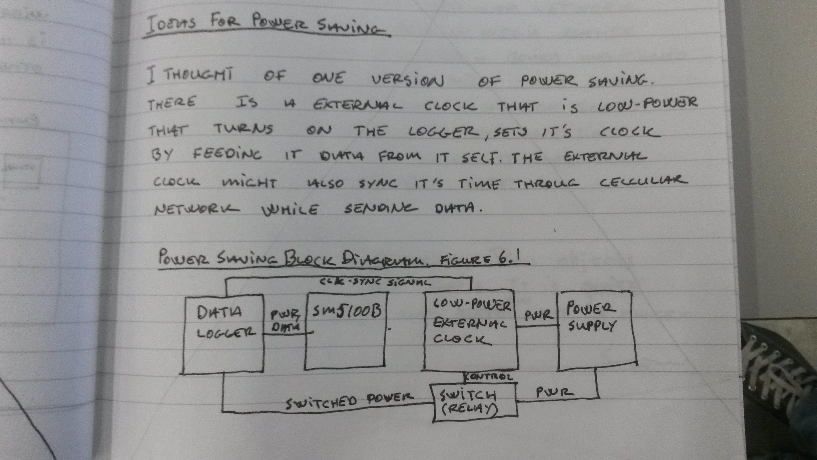
Proposal/graphics/powerSaving.jpg
