NorthernWidget/DataCollector-Foley-Mechatronics/Proposal/graphics/softwareArchitecture.jpg

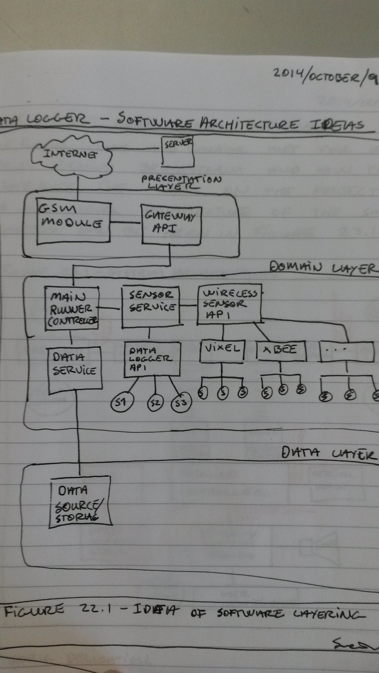
Proposal/graphics/softwareArchitecture.jpg
