NorthernWidget/DataCollector-Foley-Mechatronics/Manuals/CEL-09533-Reference-Schematic.pdf

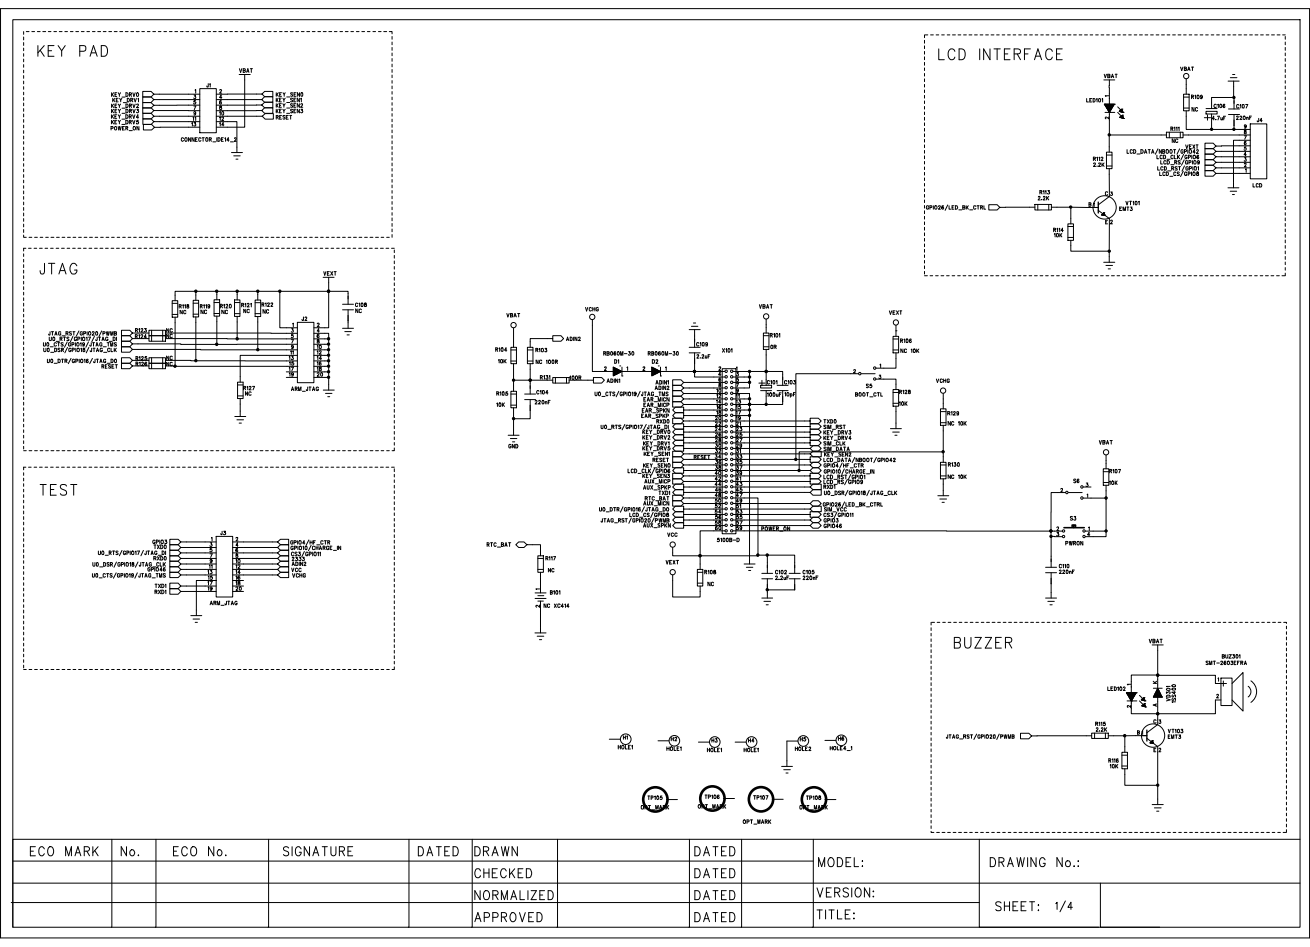
[picture p113: page 1]

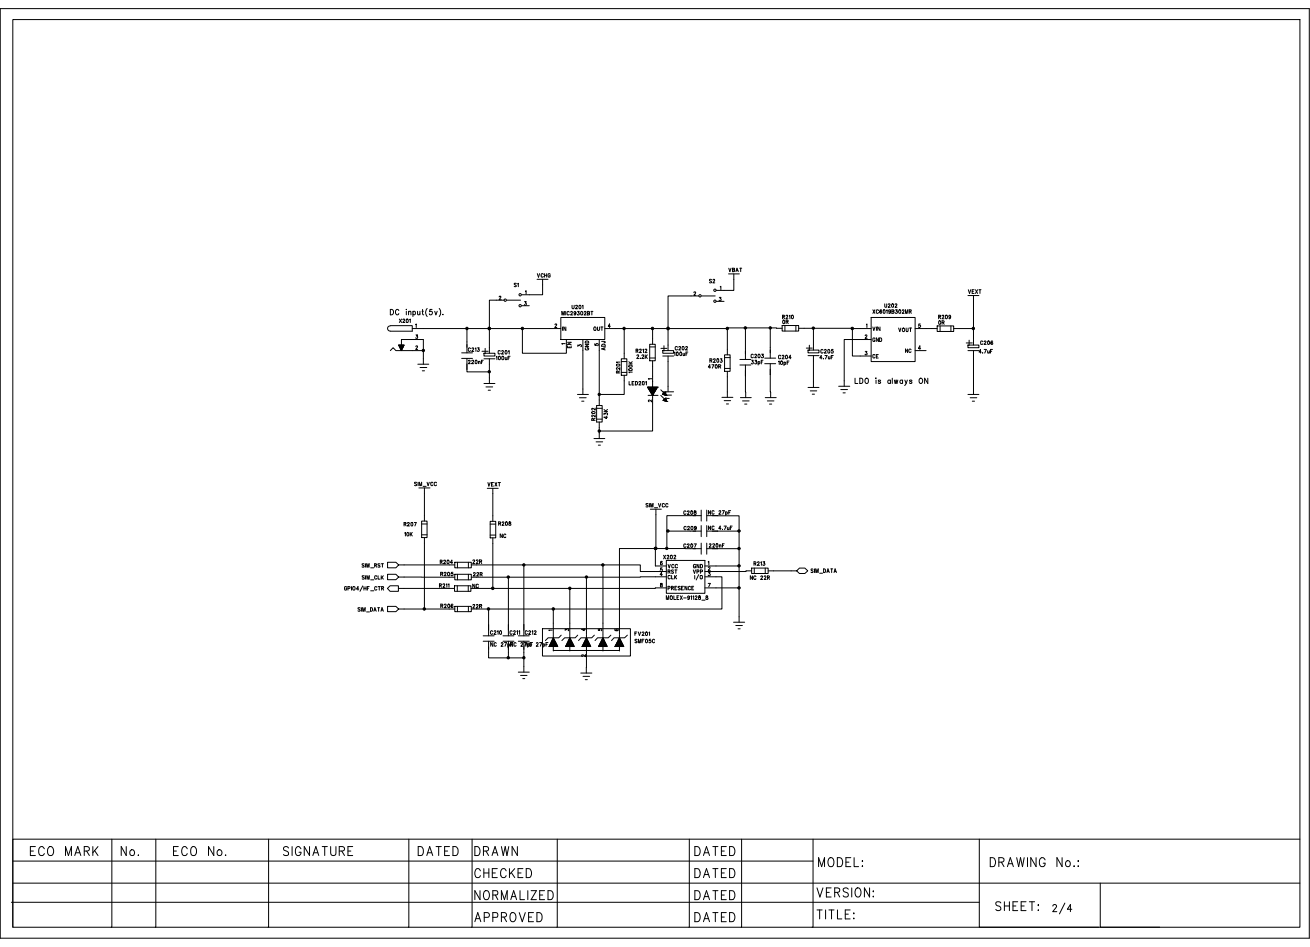
[picture p114: page 2]

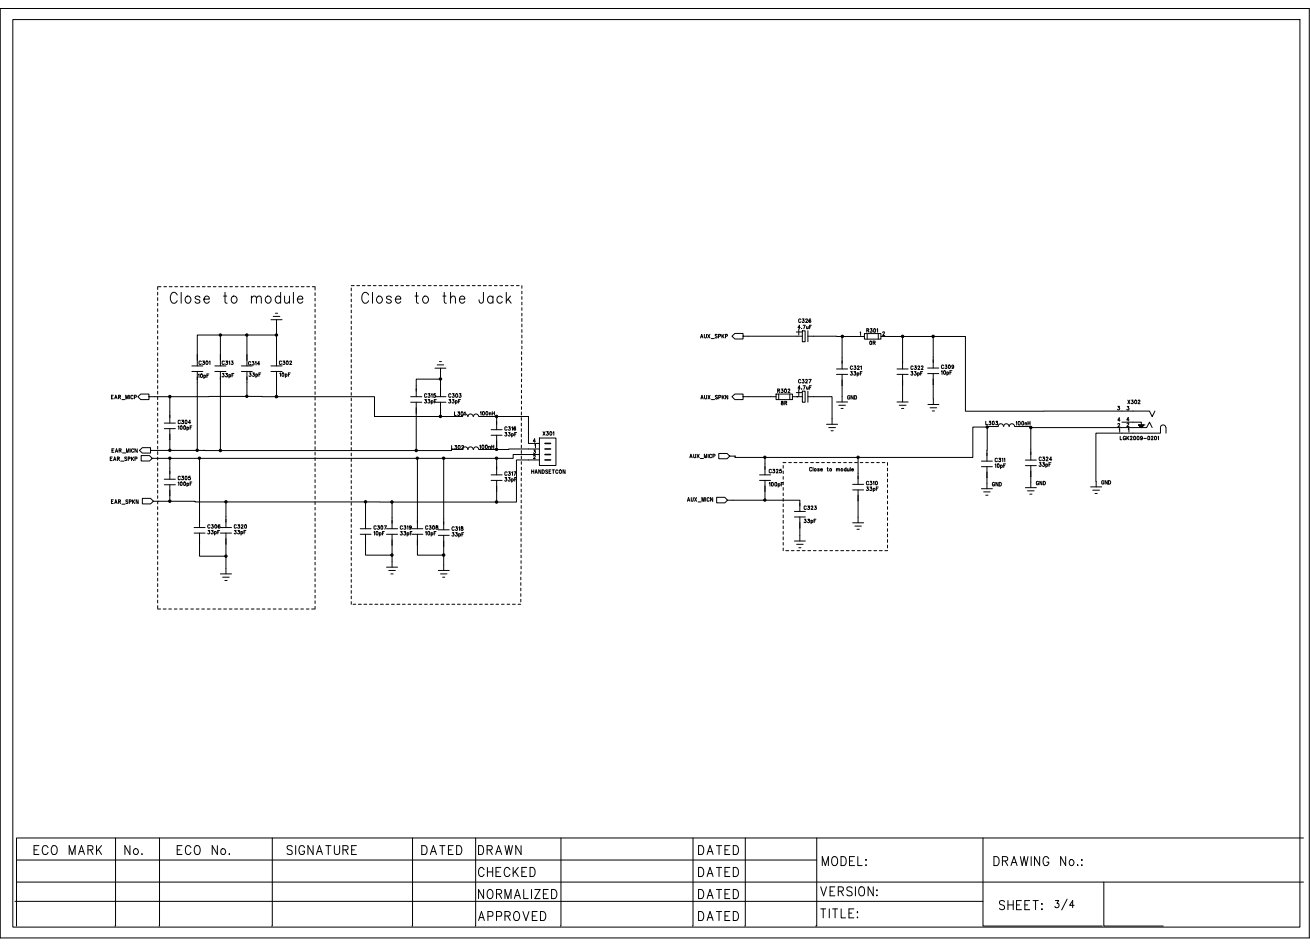
[picture p115: page 3]

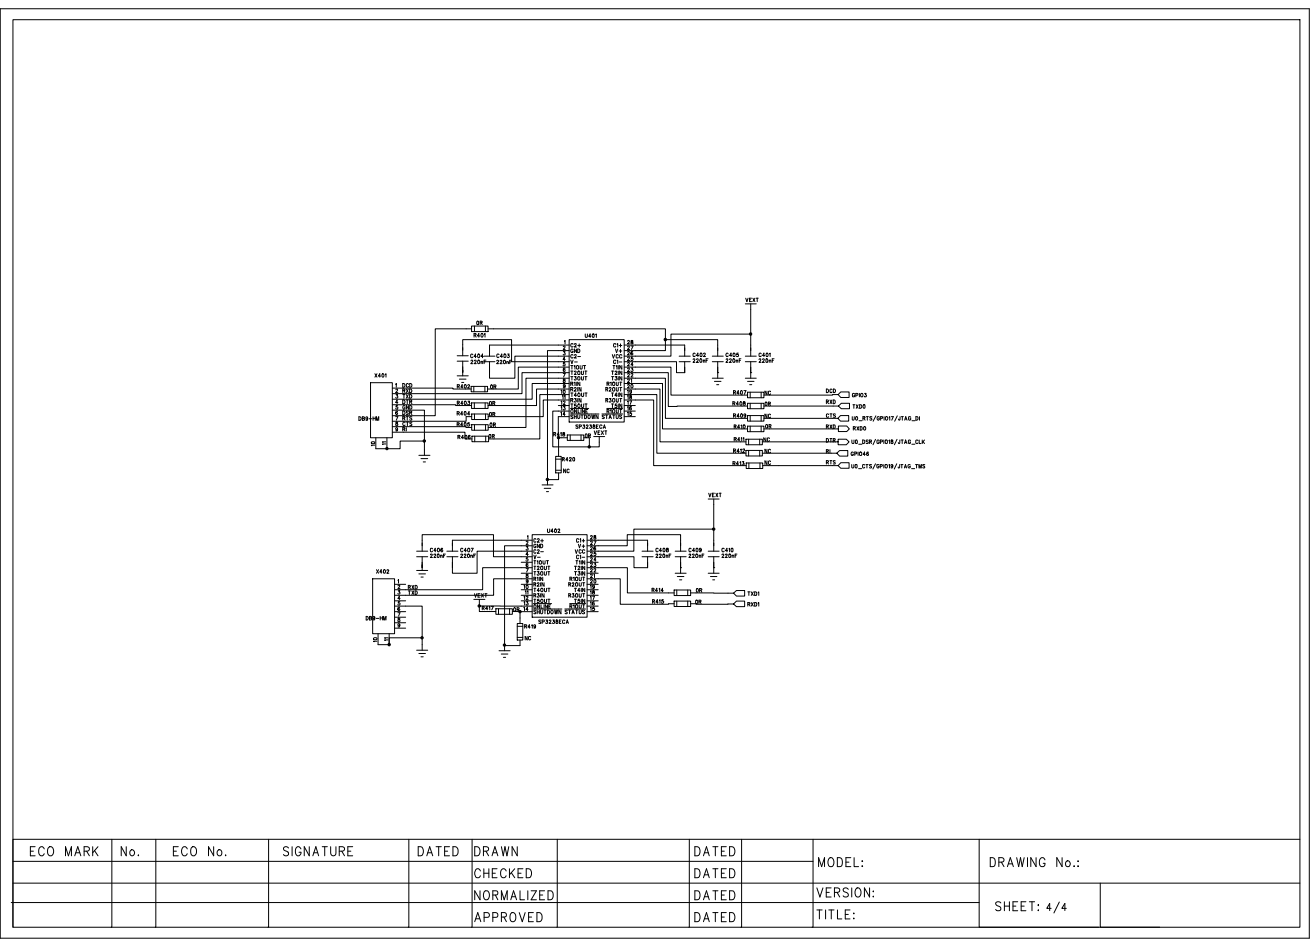
[picture p116: page 4]
