NorthernWidget/DataCollector-Foley-Mechatronics/(commit log)

2014-10-27 Shit hit the fan
2014-10-28 SHIT HIT FAN
2014-10-30 Added ArduinoJson library
2014-11-08 Added MotherHub Schematic
2014-11-08 Added SensorModule Schematic
